SemRoCo/giskardpy/test/spoon/meshes/stl/SM_Spoon_6.stl

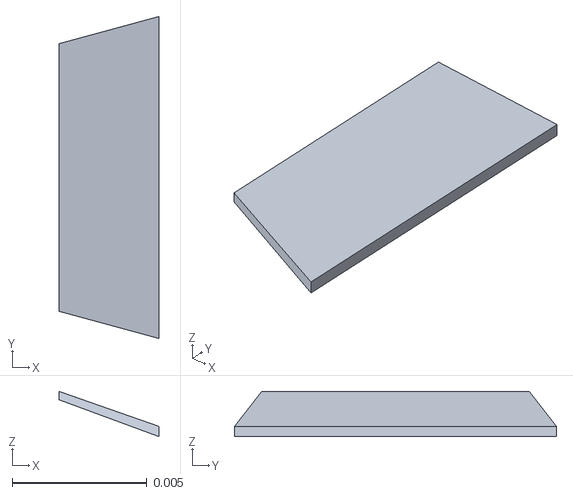
[picture p1: CAD file, 2023-09-15]
test/spoon/meshes/stl/SM_Spoon_6.stl
0.00371 x 0.012 x 0.00168
