SemRoCo/giskardpy/test/urdfs/meshes/cylinder.obj

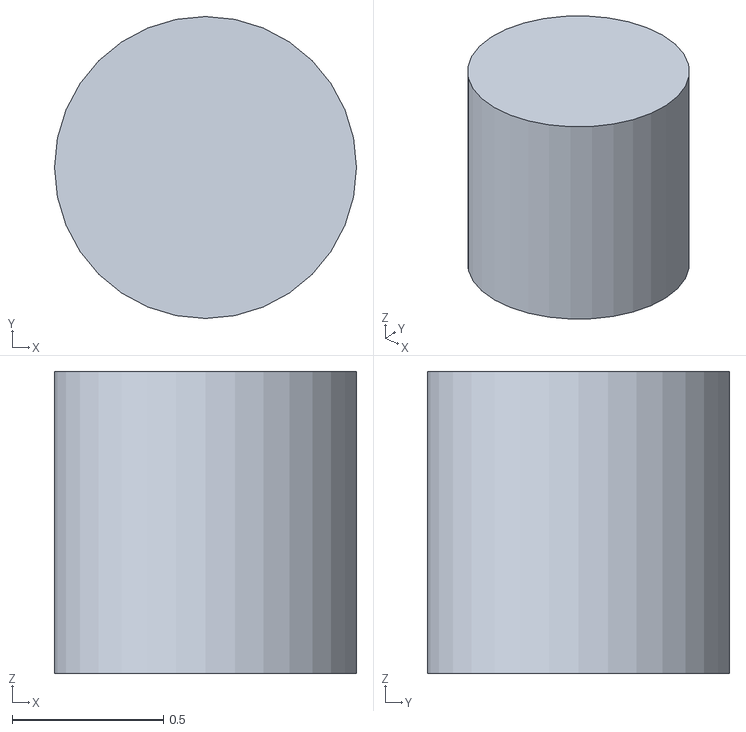
[picture p2: CAD file, 2022-06-21]
test/urdfs/meshes/cylinder.obj
1.00 x 1.00 x 1.00
