SemRoCo/giskardpy/test/spoon/meshes/stl/SM_Spoon_13.stl

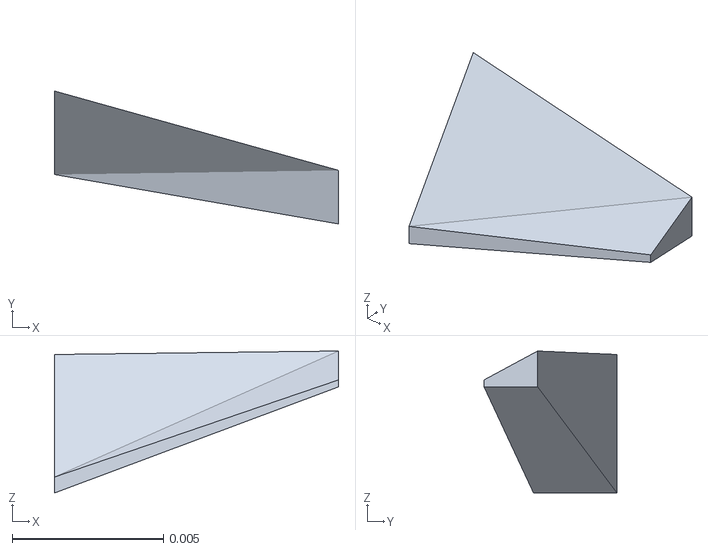
[picture p3: CAD file, 2023-09-15]
test/spoon/meshes/stl/SM_Spoon_13.stl
0.00939 x 0.0044 x 0.0047
