SemRoCo/giskardpy/test/urdfs/meshes/bowl_21.obj

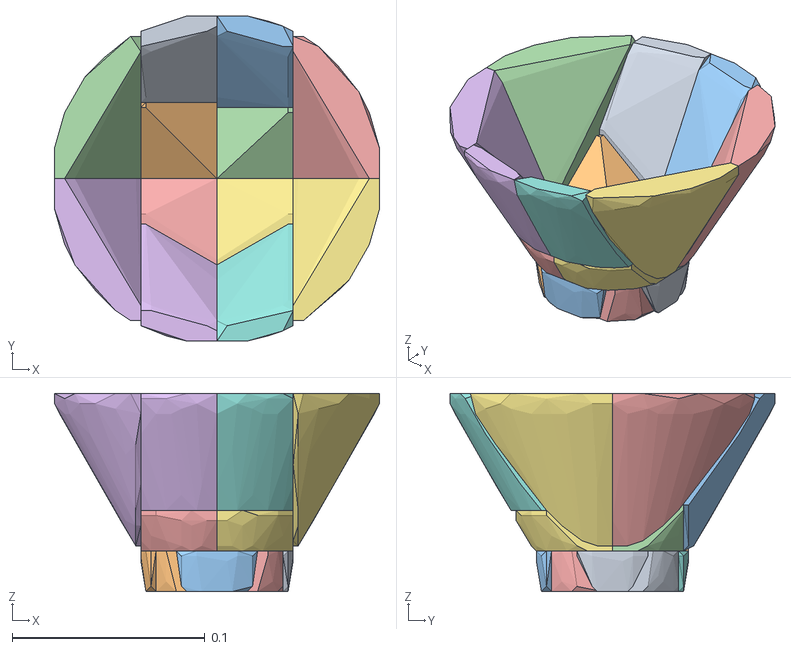
[picture p4: CAD file, 2020-11-10]
test/urdfs/meshes/bowl_21.obj
0.169 x 0.169 x 0.103
Bowl_hull_1
Bowl_hull_2
Bowl_hull_3
Bowl_hull_4
Bowl_hull_5
Bowl_hull_6
Bowl_hull_7
Bowl_hull_8
Bowl_hull_9
Bowl_hull_10
Bowl_hull_11
Bowl_hull_12
Bowl_hull_13
Bowl_hull_14
Bowl_hull_15
Bowl_hull_16
Bowl_hull_17
Bowl_hull_18
Bowl_hull_19
Bowl_hull_20
Bowl_hull_21
