SemRoCo/giskardpy/test/spoon/meshes/stl/SM_Spoon_17.stl

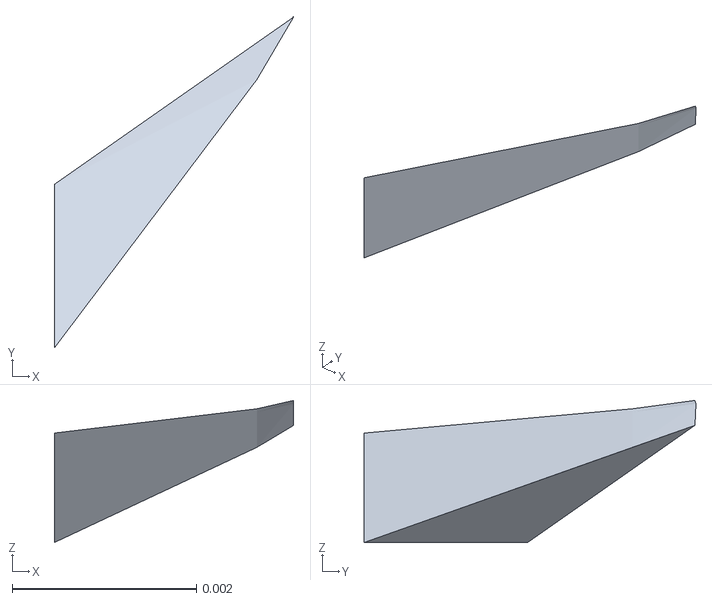
[picture p5: CAD file, 2023-09-15]
test/spoon/meshes/stl/SM_Spoon_17.stl
0.00259 x 0.0036 x 0.00154
