SemRoCo/giskardpy/test/spoon/meshes/stl/SM_Spoon_10.stl

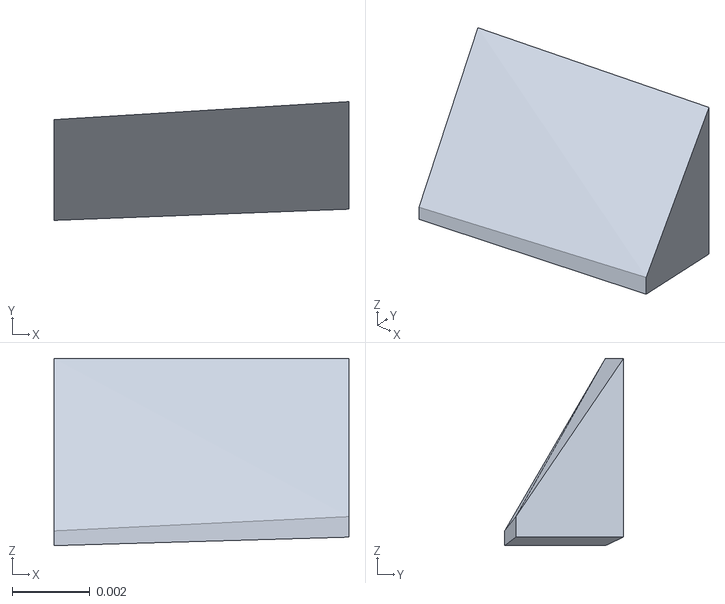
[picture p6: CAD file, 2023-09-15]
test/spoon/meshes/stl/SM_Spoon_10.stl
0.00757 x 0.00305 x 0.00481
