SemRoCo/giskardpy/test/spoon/meshes/stl/SM_Spoon_5.stl

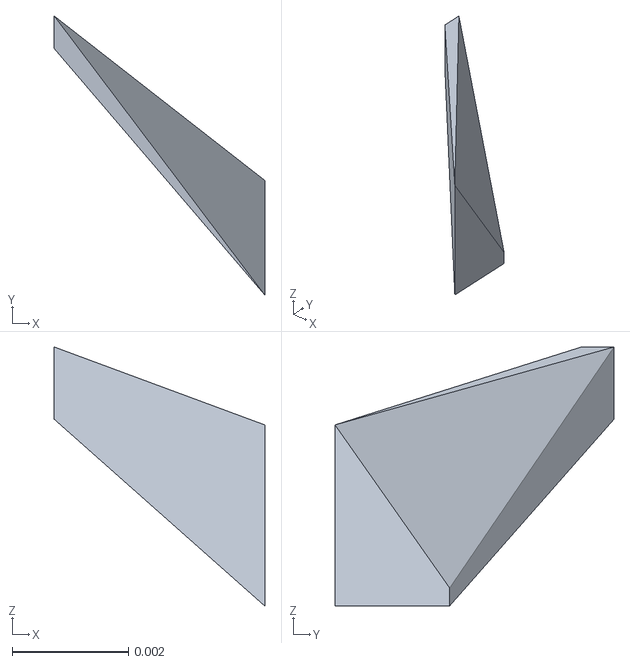
[picture p7: CAD file, 2023-09-15]
test/spoon/meshes/stl/SM_Spoon_5.stl
0.00362 x 0.0048 x 0.00445
