SemRoCo/giskardpy/test/spoon/meshes/stl/SM_Spoon_2.stl

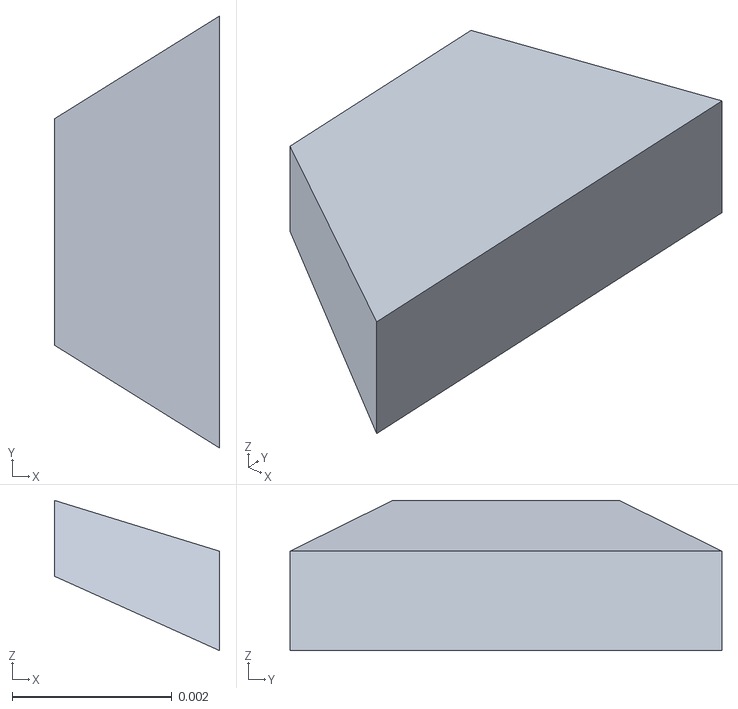
[picture p8: CAD file, 2023-09-15]
test/spoon/meshes/stl/SM_Spoon_2.stl
0.00206 x 0.0054 x 0.00188
