SemRoCo/giskardpy/test/spoon/meshes/stl/SM_Spoon_7.stl

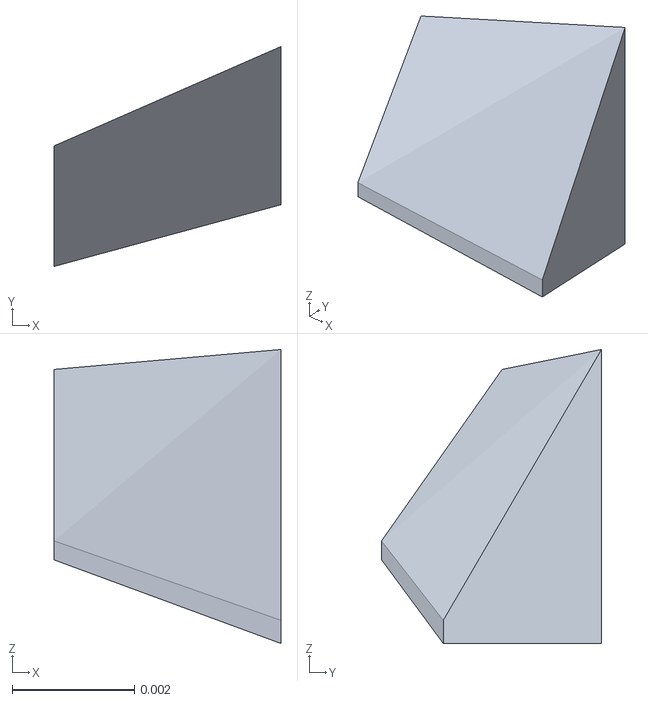
[picture p9: CAD file, 2023-09-15]
test/spoon/meshes/stl/SM_Spoon_7.stl
0.00371 x 0.0036 x 0.00481
