SemRoCo/giskardpy/test/spoon/meshes/stl/SM_Spoon_12.stl

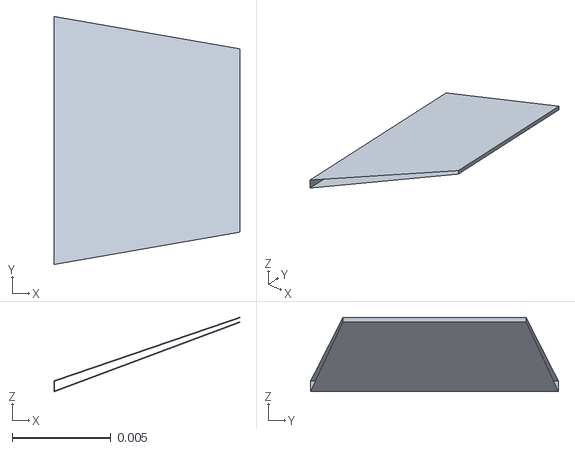
[picture p10: CAD file, 2023-09-15]
test/spoon/meshes/stl/SM_Spoon_12.stl
0.00939 x 0.0125 x 0.00374
