SemRoCo/giskardpy/test/spoon/meshes/stl/SM_Spoon_15.stl

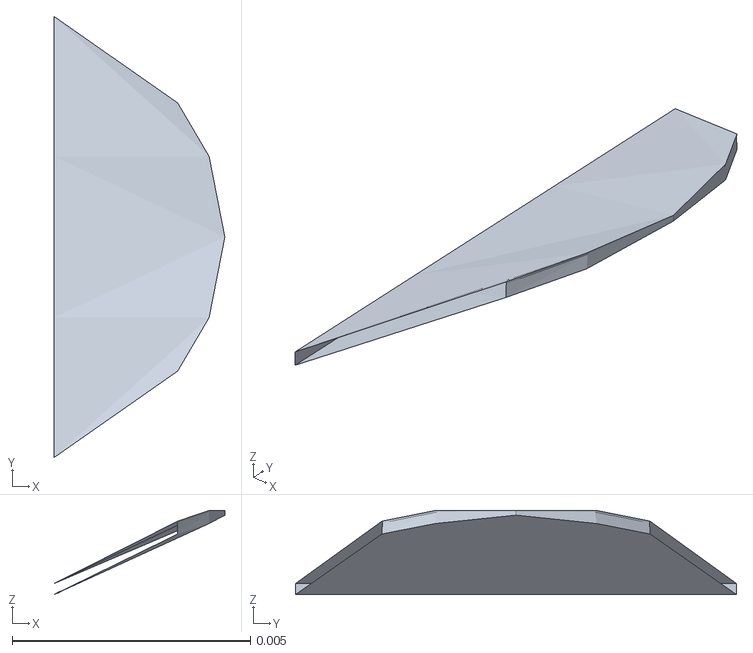
[picture p11: CAD file, 2023-09-15]
test/spoon/meshes/stl/SM_Spoon_15.stl
0.00359 x 0.00926 x 0.00177
