SemRoCo/giskardpy/test/spoon/meshes/stl/SM_Spoon_1.stl

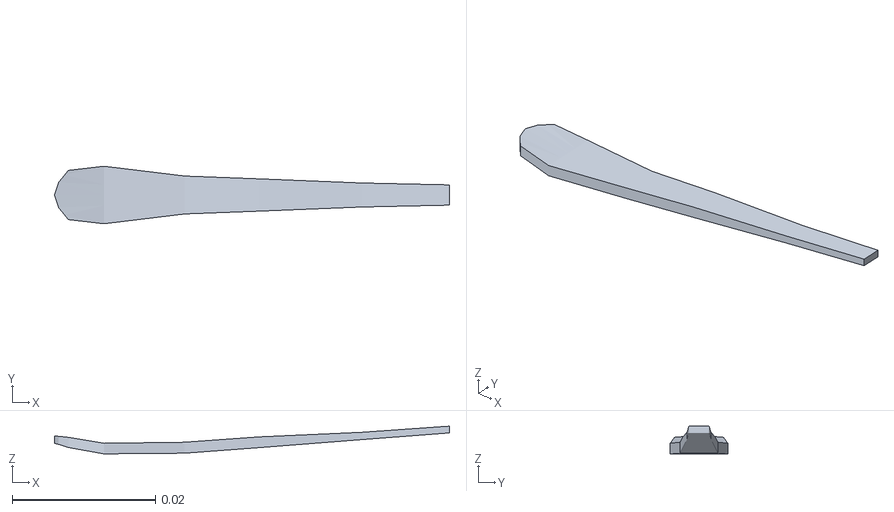
[picture p12: CAD file, 2023-09-15]
test/spoon/meshes/stl/SM_Spoon_1.stl
0.0552 x 0.00804 x 0.00388
