SemRoCo/giskardpy/test/spoon/meshes/stl/SM_Spoon_3.stl

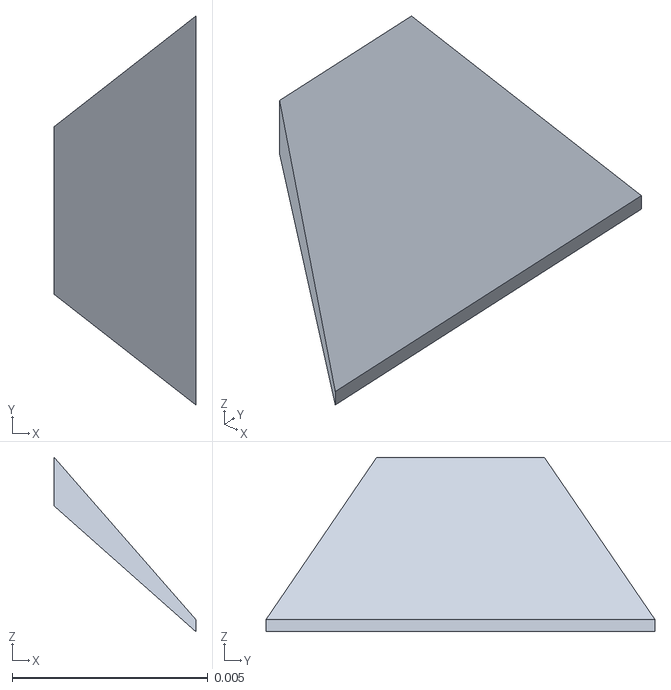
[picture p13: CAD file, 2023-09-15]
test/spoon/meshes/stl/SM_Spoon_3.stl
0.00362 x 0.00994 x 0.00445
