SemRoCo/giskardpy/test/spoon/meshes/stl/SM_Spoon_9.stl

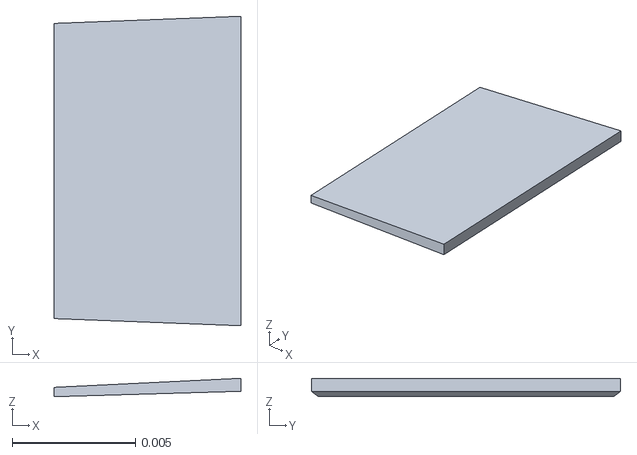
[picture p14: CAD file, 2023-09-15]
test/spoon/meshes/stl/SM_Spoon_9.stl
0.00757 x 0.0125 x 0.000746
