SemRoCo/giskardpy/(list of files, cad)

Other CAD files:
test/spoon/meshes/stl/SM_Spoon_14.stl
test/spoon/meshes/stl/SM_Spoon_16.stl
test/spoon/meshes/stl/SM_Spoon_8.stl
test/spoon/meshes/stl/SM_Spoon_11.stl
test/spoon/meshes/stl/SM_Spoon_4.stl
