SemRoCo/giskardpy/(threads)

Thread 1 (2017-10-11):

erster Durchschuß

airballking, 2017-10-11:
- [x] set up package (Simon)
- [ ] QPProblemBuilder (Adrian)
- [x] integrate qpOases (Simon ?)
- [ ] test case: point robot with 3d goal (Adrian)

@aroefer & @ichumuh is this fine for you?

ichumuh, 2017-10-11:
Yes

airballking, 2017-10-12:
I took the liberty of sketching the toy problem with specific numbers on my whiteboard. For future references, this is it:

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

Edit: I spotted a mistake in l_A: It should be (-1.3 - 1.05) instead of (1.3 - 1.05) for the second entry. Sorry about that.

Closed 2018-08-30.

Thread 5 (2017-10-30):

Runtime comparison

ichumuh, 2017-10-30:
A small benchmark using a cartesian controller on pr2. (test/test_controller.py:TestController.test_cart_controller_pr2)
Run on machine with 4ghz and 16gb ram + line_profiler.

\ | pure sympy | sympy + numpy | sympy + cython | pure symengine
--- | --- | --- | --- | ---
init (eq statements + jacobian + autowrap) | 11.5s | 21s | 53s | 0.15s
eq statements | 0.85s | 0.85s | 0.85s | <0.001s
jacobian | 9.8s | 9.8s | 9.8s | 0.05s
autowrap | - | 10.5s | 43s | -
get_next_command | 108s | 0.01s | 0.00025s | 0.049s

airballking, 2017-10-30:
@ichumuh Thanks for providing! Some quick questions:

(1) On what type of machine was that run?
(2) Could you describe (in one sentence) what 'eq statements', 'jacobian', and 'next_cmd (per hit)' mean? I feel unsure about some of them.

As a guideline, the controller should run at least 100Hz to be useful on the real robot. Faster is always better.

Also, this is running qpOases, right?

Finally, do think it makes sense to include Theano and Tensorflow into the comparison?

ichumuh, 2017-10-30:
(1) I have added the machine speccs to the opening post, the overall test is about 25-50% faster without the profiler, but hard to tell if everything is equally effected. Sorry that I forgot to mention that earlier.
(2)

- eq statements: CartesianController.make_constraints() + robot.add_chain_joints() (which creates the forward kinematic equations in sympy terms)
- jacobian: line 74 in qpbuilder
- next_cmd: controller.get_next_cmd() call, this consists of function evaluation and qp problem solving

(3) yes, and the runtime is negligible

(4) I would like to include them but it's hard for me to estimate how much time it will take.

airballking, 2017-11-01:
@ichumuh thanks for the updates and infos. What is your next step on this?

ichumuh, 2017-11-02:
I ran a few more tests -without- line profiler but on the same machine. This time I omitted pure sympy because it's too slow anyway. The next command was called 200 times.
1. For the first benchmark I used the pr2 joint state controller test as an example for a very simple controller:

\ | sympy + numpy | sympy + cython | symengine
---|---|---|---
init | 1.3 | 32 | 0.026
eq statements | 0.3 | 0.3 | 0.003
jacobian | 0.003 | 0.003 | 0.0000003
autowrap | 0.97 | 31.5 | -
get_next_command | 0.00028 | 0.00017 | 0.0055
get_next_cmd std | 0.000005 | 0.000005 | 0.0012

2. the cartesian controller from the opening post but, again, this time without the line profiler:

\ | sympy + numpy | sympy + cython | symengine
---|---|---|---
init | 7.8 | 38 | 0.125
eq statements | 0.32 | 0.32 | 0.013
jacobian | 3.2 | 3.2 | 0.046
autowrap | 4.2 | 31 | -
get_next_command | 0.0095 | 0.00013 | 0.048
get_next_cmd std | 0.0024 | 0.00004 | 0.0009

3. I have tried out a cartesian controller with the additional constraint that it tries to stay on a straight line between start and goal pose:

\ | sympy + numpy | sympy + cython | symengine
---|---|---|---
init | 13.4 | 44.2 | 0.25
eq statements | 0.4 | 0.4 | 0.03
jacobian | 5.7 | 5.7 | 0.11
autowrap | 7.2 | 37 | -
get_next_cmd mean | 0.017 | 0.00018 | 0.098
get_next_cmd std | 0.0003 | 0.000004 | 0.001

4. a controller that tries to create a certain pose of both hands relative to each other, which is what you have suggested yesterday:

\ | sympy + numpy | sympy + cython | symengine
---|---|---|---
init | 140 | 170 | 0.36
eq statements | 0.31 | 0.31 | 0.003
jacobian | 123 | 123 | 0.12
autowrap | 16 | 46 | -
get_next_command | 0.043 | 0.00012 | 0.23
get_next_cmd std | 0.0007 | 0.000004 | 0.0035

It should be noted that it takes 25s to compile the fk equations for the pr2 using cython and 0.9 using numpy. This is done every time even though it's unnecessary for the joint state controller.

As expected, symengine has no problem with differentiating huge equations. It also seems like cython's get_next_command call does not correlate with the function complexity at all.

Next I'm gonna work on adding tensorflow and theano to that list

airballking, 2017-11-02:
@ichumuh Thanks a lot for this update!

I have two questions.

When you say "it takes ...0.9s... to compile the fk equations for the pr2 using ... numpy...", do you mean that if we just write out regular numpy expressions we get (1) runtime compilation at around 1 Hz, and (2) subsequent evaluation at around 20Hz?

Why is it not possible to combine symengine with numpy or cython?

ichumuh, 2017-11-02:
Sorry, compile was not the correct word. I was referring to the autowrap step. It consists of two parts. (1) autowrap fk expressions (2) autowrap expressions that produce the matrices for the qp problem.

I need to evaluate the fk to set the default goal in all but the joint state controller. I also need it as the starting point for the line in the 3. controller. If we want to change the controller during runtime we can skip the (1) part. That would save 25s with cython for all subsequent controllers.
Additionally, we could probably compute and store this offline. Especially for cython this would save 25s in the autowrap step.

It is possible to combine these two, but symengine does not have an autowrap function.
That means we have to translate it into a sympy expression and then call sympy.autowrap. My guess is that this step would take as much time as listed in the "eq statements" row.
Do you want me to try that out?

isuruf, 2017-11-02:
symengine's lambdify has 2 backends. `lambda` and `llvm` which are comparable to sympy's `numpy` and `cython` methods.

ichumuh, 2017-11-03:
Thanks for the info! I'm gonna try that out.

airballking, 2017-11-03:
@isuruf Thanks for the tip! Which of the two backends is the default one? And, can you comment on which one is faster when generating expression vs. evaluating expressions?

Also, I am curious how you found out about our project. Are you also interested in robot control?

ichumuh, 2017-11-03:
In sympy, the method that turns expressions into numpy functions is called lambdify but the one for cython is called autowrap. I just called everything autowrap because I thought it was less confusing. If I use symengines lambdify, which I currently don't, it should introduce the "autowrap" step but speed up the evaluation time.

ichumuh, 2017-11-03:
@airballking I added symengine + lambda to the tables above. Like @isuruf said, it's comparable to numpy. lambdify takes less time but the resulting function seems to be slower.
If I try to use llvm, symengine tells me that it's not compiled with llvm support. I guess I would have to compile it from sources.

airballking, 2017-11-03:
@ichumuh thanks for the update of the tables regarding symengine + lambda.

Looking at symengine + lambda would indeed be interesting.

ichumuh, 2017-11-03:
I have compiled symengine from sources with llvm support and updated the tables. It's almost as fast as cython but the autowrap step is also super fast. The lambda version is faster as well, seems like symengine from pip is outdated.
However, with this installation my line constraint for the cart controller somehow produces infinities which causes the test to fail.
I'm gonna investigate some more.

airballking, 2017-11-03:
Aha. Sounds promising! :)

ichumuh, 2017-11-03:
I have found the problem with the line constraint, fixed it and added the number to the table.
Looks pretty good to me. The only problem left is that we have to compile symengine from sources.
I think I don't have to try out theano and tensorflow anymore right?

airballking, 2017-11-06:
@ichumuh So, you recommend going with symengine with LLVM as a backend? Looking at the worst cases from your table, that gives us 3s for compiling a new motion and 1250Hz of update frequency, correct. The former is a bit slow, while the latter is very nice.

If these numbers turn out to be correct, I think we'll have to look into caching compiled expression. @ichumuh @amaldo @aroefer What do you think?

@ichumuh how much work is it to compile symengine + LLVM from source. Do you see a way of automating the process using the ROS infrastructure?

@ichumuh I'd be interesting in comparing with Theano? How much time would it take you to do the comparison?

ichumuh, 2017-11-06:
symengine + LLVM outperforms everything else. So as long as we don't come up with anything better I think thats the way to go. I have just run the tests on my office pc (3.4 ghz 16gb ram). The worst case for the init was 4s and get_next_command 0.0012.

I think it should be relatively easy to automate this using the ros infrastructure because symengine uses cmake.

airballking, 2017-11-06:
Compiling via CMake is indeed a good fit with ROS.

Given that you told me offline that you guess it would take 1-3 days to benchmark Theano, I think we should leave that for a later time and go with symengine + LLVM for now.

isuruf, 2017-11-30:
> Also, I am curious how you found out about our project.
Just a random github search.

> Are you also interested in robot control?
Nope

If you are not doing any broadcasting or have multiple outputs, following might be faster. (It avoids a few checks in python)
```
def f(**kwargs):
        filtered_args = [kwargs[k] for k in str_params]
        out = np.empty(function.shape)
        fast_f.unsafe_real(np.array(filtered_args, dtype=np.double), out)
        return  np.nan_to_num(out)
```

Closed 2022-04-06.

Thread 15 (2018-06-28):

Missing dependency

NeumannM89, 2018-06-28:
I get "Cannot locate rosdep definition for [ros_kinetic_urdfdom_py]" during the install.

ichumuh, 2018-06-28:
try to install it manually
sudo apt-get install ros-kinetic-urdfdom-py

airballking, 2018-06-29:
I think adding ```urdfdom_py``` and the likes to the ```package.xml``` would be the better option. Then, the install instructions would automatically cause the installation.

ichumuh, 2018-06-29:
It is listed in package.xml, but rosdep didn't manage to install it.

airballking, 2018-06-29:
Oh! I just checked, the dependency was incorrectly stated. I just fixed that on that master branch. I guess we can close the issue, right?

ichumuh, 2018-06-29:
yes

Closed 2018-06-29.

Thread 17 (2018-08-17):

Change SymengineController's interface

ARoefer, 2018-08-17:
Hi,

I've recently updated an old system of mine to work with the new v0.2 version. I noticed that the new SymEngineController can only be passed a URDF path, not a Robot instance. I think this interface should be changed to accept a complete robot, since there's information that can not be encoded in URDF, like a model for base navigation.
Of course I can still inherit from the controller and override __init__ completely, but that's very unclean. To afford both use cases, the class could offer a static constructor which uses a URDF path, or the type of the given parameter could be analyzed in __init__.

ichumuh, 2018-08-20:
I agree. On the hypothesis (the name of a cool python testing framework) branch, I'm currently writing tests, refactoring and writing documentation. On that branch SymengineController only accepts a Robot class in init, to remove the urdf dependency from that class. This branch will get merge into devel_v0.2 and master when I'm finished.

ARoefer, 2018-08-20:
Alright, thank you for the update! Looking forward to the merge.

Closed 2018-08-20.

Thread 20 (2018-11-20):

Improving usability of the controller interface

ARoefer, 2018-11-20:
In my opinion, the current SymengineController interface is too complicated. It requires users to provide both the free symbols in their expressions, as well as specify exactly which joints to use. There are a couple of problems with this:

1. It requires them to manually keep track of all their free symbols and passing them to the piece of code, initializing the controller. This requires a lot of data passing, which I think is hostile to the idea of modularization.
2. Not sure whether I remember this correctly, but the used joints and the joints referenced in the soft constraints need to coincide. Meaning the user has to keep track of which joints are actually used in their expressions, leading to them having to have a very detailed knowledge of the robot they're using.
3. All the information needed to initialize the controller is already present in the soft constraints.

My suggestion is redesigning the controller initialization to include an algorithm like this one:

```python
def configure_controller(controller, robot, soft_cs, filter=set()):
    free_symbols = set()

    # Find free symbols in soft constraints
    for sc in soft_cs.values():
        for f in sc:
            if hasattr(f, 'free_symbols'):
                free_symbols = free_symbols.union(f.free_symbols)

    # Select joints referenced in soft constraints which are not supposed to be filtered out
    controller.set_controlled_joints([j for j in robot.get_joint_names() if robot.joint_to_symbol_map[j] in free_symbols and j not in filter])

    # Find additional free symbols in joint constraints
    for jc in controller.joint_constraints.values():
        for f in jc:
            if hasattr(f, 'free_symbols'):
                free_symbols = free_symbols.union(f.free_symbols)

    # Find additional free symbols in hard constraints
    for hc in controller.hard_constraints.values():
        for f in hc:
            if hasattr(f, 'free_symbols'):
                free_symbols = free_symbols.union(f.free_symbols)

    # Setting soft constraints and free symbols
    controller.update_soft_constraints(soft_cs, free_symbols)

    return free_symbols
```
I've used an algorithm like this under the old controller interface in another project of mine ([Implementation](https://github.com/ARoefer/gebsyas/blob/the_messed_up_but_working_branch/src/gebsyas/bc_controller_wrapper.py)).
@ichumuh referenced [here](https://github.com/symengine/symengine.py/issues/211) that the free_symbols call is very slow on large matrices. Personally, I've not had this problem when directly working on the expressions, but I've not profiled it either. This is definitely something to investigate.

ichumuh, 2018-11-20:
I'll make the free symbols optional, if I have some time, and check if it is faster to extract them from the constraints instead of the jacobian.

Regarding the controlled joint names:

1. They are provided by the whole body controller, so you don't really have to keep track of the joints.
2. For my robots, the whole body controller never controlled all the joints from the urdf, so I'd always had to filter.
3. I could make this optional as well, though I'd keep the current whitelist approach. A filter requires you to figure out which joints your controller does not control, which is more difficult I belief.

ARoefer, 2018-11-20:
Oh, I must've overlooked the whole body controller.
On point 3: I don't quite get how the filter requires me to know which joints are not controlled by it. The way I've always thought about the filter is as a blacklist.
Whether one prefers black- or whitelists is a matter of discussion. Personally, I think blacklists are easier to use, than whitelists, but one could also view a blacklist as a "loose cannon" approach.

ichumuh, 2018-11-21:
> I don't quite get how the filter requires me to know which joints are not controlled by it.

Isn't this kind of the definition? All the joints in the filter are removed. So if your controller doesn't control the gripper, you have to somehow figure out which joints belong to the gripper. I'd do it by computing the difference between the controlled joints and a list of all joints. This is more work than just handing over the list of joints that my controller controls. So at least for my usecases, a whitelist is more convenient.

ARoefer, 2018-11-21:
I think the difference here is really in practical usage. Instead of formulating the filter as a post processing step which removes joints, I'd view it as a pre processing which keeps joints from being added. Either way, as you point out, convenience is dependant on use case

ARoefer, 2018-12-04:
Hello, I had a free moment and decided to record the build times for some of my controllers. These are my results:

| N Symbols | N Constraints | Time Matrix Extraction | Time Constraint Extraction | Remaining Generation Time |
|-----------|---------------|------------------------|----------------------------|---------------------------|
| 103       | 20            | 0.00081s               | 0.00117s                   | 0.06416s                  |
| 116       | 28            | 0.00196s               | 0.00206s                   | 0.09415s                  |

So overall extracting the symbols from the matrix directly, seems to be faster than extracting the symbols  iteratively, though the gap seems to narrow with a rising number of constraints. I suspect it might be, that free_symbols is more complex on larger objects, while the time for the python iterations does not increase at the same rate.

Given your previous concerns, I assume you use waaaay more constraints than I do, which is why the symbol extraction becomes such an issue?

ichumuh, 2018-12-27:
Seems like .free_symbols is fast [now](https://github.com/symengine/symengine.py/issues/211#event-2043487315), which resolves this problem. With that speed I can probably remove the input parameter and always call .free_symbols.

ichumuh, 2019-01-14:
I finally had some time to look into this. The symengine controller doesn't require free symbols anymore and will use .free_symbols if none are supplied. But this is only fast if symengine is up to date.

Closed 2019-01-14.

Thread 74 (2021-04-14):

PyBullet(==3.0.8<3.1.2) Import Error

tlipps, 2021-04-14:
With the current installation script in the readme.md, testing and running giskardpy is not possible, due to of a pybullet import error. `sudo pip install pybullet` from the install script installs currently at least the version 3.1.2 on melodic. If the test code from the function `test_bowl_and_cup` is run, the following error log is produced:

```
ERROR: not found: /home/thomas/ros_ws/src/giskardpy/test/test_integration_pr2.py::TestCollisionAvoidanceGoals::test_bowl_and_cup
(no name '/home/thomas/ros_ws/src/giskardpy/test/test_integration_pr2.py::TestCollisionAvoidanceGoals::test_bowl_and_cup' in any of [<Module 'test/test_integration_pr2.py'>])

test/test_integration_pr2.py:None (test/test_integration_pr2.py)
ImportError while importing test module '/home/thomas/ros_ws/src/giskardpy/test/test_integration_pr2.py'.
Hint: make sure your test modules/packages have valid Python names.
Traceback:
/usr/lib/python2.7/dist-packages/_pytest/python.py:403: in _importtestmodule
    mod = self.fspath.pyimport(ensuresyspath=importmode)
/usr/lib/python2.7/dist-packages/py/_path/local.py:668: in pyimport
    __import__(modname)
/usr/lib/python2.7/dist-packages/_pytest/assertion/rewrite.py:213: in load_module
    py.builtin.exec_(co, mod.__dict__)
test_integration_pr2.py:22: in <module>
    from giskardpy.robot import Robot
../src/giskardpy/robot.py:12: in <module>
    from giskardpy.pybullet_world_object import PyBulletWorldObject
../src/giskardpy/pybullet_world_object.py:4: in <module>
    import giskardpy.pybullet_wrapper as pw
../src/giskardpy/pybullet_wrapper.py:6: in <module>
    import pybullet as p
E   ImportError: /home/thomas/.local/lib/python2.7/site-packages/pybullet.so: undefined symbol: PyUnicode_AsUTF8

```

The problem can be solved by using the pybullet version 3.0.8 (maybe later versions work too).

ichumuh, 2021-04-15:
It works with python3/noetic. So it seems like they broke the python 2 support. I guess that is never going to get fixed. Especially because the don't allow issues on their github anymore.
You can switch to 20.04+noetic if you want. Giskards devel works fine with it.

ichumuh, 2021-04-15:
If you do, you should look at this issue: https://github.com/code-iai/iai_maps/issues/83#issue-782218694

ichumuh, 2021-04-15:
updated readme e44d0dcf01b6fc3b57690556994d8796c91c134c

Closed 2022-04-06.

Thread 78 (2021-08-19):

MPC Solver Comparision

tlipps, 2021-08-19:
Currently profiled the cplex and gurobi solver on the mpc branch.
CPLEX LOG:
```
============================= test session starts ==============================
platform linux -- Python 3.8.10, pytest-6.2.4, py-1.10.0, pluggy-0.13.1
rootdir: /home/thomas/ros_ws/src/giskardpy
plugins: hypothesis-6.14.1
Academic license - for non-commercial use only - expires 2021-10-17
Using license file /home/thomas/gurobi.lic
collected 1 item

test/test_integration_pr2.py [/unnamed]: deleting tmp test folder
[/unnamed]: init ros
 [1mstarted roslaunch server http://thomas-MS-7C91:43495/ [0m

SUMMARY
========

PARAMETERS
 * /rosdistro: noetic
 * /rosversion: 1.15.11

NODES

 [1mROS_MASTER_URI=http://localhost:11311 [0m
 [1mprocess[joint_trajectory_splitter-1]: started with pid [64102] [0m
[INFO] [1629978455.212171]: [/tests]: --> added ground_plane to world
[INFO] [1629978455.218782]: [/tests]: --> added pybullet_hack to world
[INFO] [1629978455.633305]: [/tests]: --> added pr2 to world
[INFO] [1629978455.808199]: [/tests]: loaded self collision matrix /home/thomas/ros_ws/src/giskardpy/tmp_data/collision_matrix//pr2/ecde0c3a330b5e4a094b7ca46100a7e5
[INFO] [1629978455.812867]: [/tests]: waiting for action server '/whole_body_controller/follow_joint_trajectory' to appear
[INFO] [1629978455.813671]: [/tests]: successfully connected to action server
[INFO] [1629978455.821130]: [/tests]: Writing /home/thomas/ros_ws/src/giskardpy/tmp_data/tree.dot/svg/png
[INFO] [1629978458.040919]: [/tests]: resetting giskard
[INFO] [1629978458.046792]: [/tests]: <-- removed object ground_plane from world
[INFO] [1629978458.048391]: [/tests]: <-- removed object pybullet_hack from world
[INFO] [1629978458.233745]: [/tests]: loaded self collision matrix /home/thomas/ros_ws/src/giskardpy/tmp_data/collision_matrix//pr2/ecde0c3a330b5e4a094b7ca46100a7e5
[INFO] [1629978458.240826]: [/tests]: --> added ground_plane to world
[INFO] [1629978458.247606]: [/tests]: --> added pybullet_hack to world
[INFO] [1629978459.266986]: [/tests]: Received new goal.
[INFO] [1629978459.276686]: [/tests]: Parsing goal message.
[INFO] [1629978459.277985]: [/tests]: Adding constraint of type: 'JointPositionList'
[INFO] [1629978459.284542]: [/tests]: done parsing goal message
[INFO] [1629978459.882159]: [/tests]: Using QP Solver 'cplex'
[INFO] [1629978459.883301]: [/tests]: Constructing new controller with 494 constraints and 557 free variables...
[INFO] [1629978459.947023]: [/tests]: computed Jacobian in 0.00059s
[INFO] [1629978460.127668]: [/tests]: Compiled symbolic controller in 0.02695s
[INFO] [1629978461.598317]: [/tests]: found loop, stopped planning.
[INFO] [1629978461.600065]: [/tests]: found goal trajectory with length 1.05s in 2.3144121170043945s
[INFO] [1629978462.134066]: [/tests]: Planning succeeded.
[INFO] [1629978462.135605]: [/tests]: Sending trajectory to robot.
[INFO] [1629978464.737757]: [/tests]: Robot successfully executed the trajectory.
[INFO] [1629978464.740212]: [/tests]: Successfully executed goal.
[INFO] [1629978465.465906]: [/tests]: --> added kitchen to world
[INFO] [1629978466.592754]: [/tests]: Received new goal.
[INFO] [1629978466.622580]: [/tests]: adding 24 external collision avoidance constraints
[INFO] [1629978466.734150]: [/tests]: adding 67 self collision avoidance constraints
[INFO] [1629978466.735111]: [/tests]: Parsing goal message.
[INFO] [1629978466.735846]: [/tests]: Adding constraint of type: 'CartesianPosition'
[INFO] [1629978466.739642]: [/tests]: Adding constraint of type: 'CartesianOrientation'
[INFO] [1629978466.754561]: [/tests]: done parsing goal message
[INFO] [1629978466.798315]: [/tests]: Using QP Solver 'cplex'
[INFO] [1629978466.800689]: [/tests]: Constructing new controller with 588 constraints and 651 free variables...
[INFO] [1629978466.916219]: [/tests]: computed Jacobian in 0.03585s
[INFO] [1629978467.234375]: [/tests]: Compiled symbolic controller in 0.05548s
[INFO] [1629978474.393086]: [/tests]: found goal trajectory with length 3.4000000000000004s in 7.637590169906616s
[INFO] [1629978475.078298]: [/tests]: Planning succeeded.
[INFO] [1629978475.080597]: [/tests]: Sending trajectory to robot.
[INFO] [1629978479.983126]: [/tests]: Robot successfully executed the trajectory.
[INFO] [1629978479.986314]: [/tests]: Successfully executed goal.
[INFO] [1629978480.613513]: [/tests]: Received new goal.
[INFO] [1629978480.644307]: [/tests]: adding 24 external collision avoidance constraints
[INFO] [1629978480.731220]: [/tests]: adding 67 self collision avoidance constraints
[INFO] [1629978480.732925]: [/tests]: Parsing goal message.
[INFO] [1629978480.733775]: [/tests]: Adding constraint of type: 'CartesianPosition'
[INFO] [1629978480.737611]: [/tests]: Adding constraint of type: 'CartesianOrientation'
[INFO] [1629978480.752850]: [/tests]: done parsing goal message
[INFO] [1629978480.786566]: [/tests]: Using QP Solver 'cplex'
[INFO] [1629978480.796820]: [/tests]: Constructing new controller with 588 constraints and 651 free variables...
[INFO] [1629978480.919541]: [/tests]: computed Jacobian in 0.03618s
[INFO] [1629978481.214229]: [/tests]: Compiled symbolic controller in 0.04926s
[INFO] [1629978484.757354]: [/tests]: found goal trajectory with length 1.9500000000000002s in 4.0035388469696045s
[INFO] [1629978485.416147]: [/tests]: Planning succeeded.
[INFO] [1629978485.418221]: [/tests]: Sending trajectory to robot.
[INFO] [1629978488.920438]: [/tests]: Robot successfully executed the trajectory.
[INFO] [1629978488.923079]: [/tests]: Successfully executed goal.
[INFO] [1629978489.556112]: [/tests]: --> added cup to world
[INFO] [1629978489.567816]: [/tests]: --> added bowl to world
[INFO] [1629978490.078862]: [/tests]: Received new goal.
[INFO] [1629978490.116721]: [/tests]: adding 24 external collision avoidance constraints
[INFO] [1629978490.213189]: [/tests]: adding 67 self collision avoidance constraints
[INFO] [1629978490.214684]: [/tests]: Parsing goal message.
[INFO] [1629978490.215931]: [/tests]: Adding constraint of type: 'JointPositionList'
[INFO] [1629978490.223738]: [/tests]: done parsing goal message
[INFO] [1629978490.262139]: [/tests]: Using QP Solver 'cplex'
[INFO] [1629978490.268890]: [/tests]: Constructing new controller with 585 constraints and 648 free variables...
[INFO] [1629978490.370488]: [/tests]: computed Jacobian in 0.03480s
[INFO] [1629978490.638755]: [/tests]: Compiled symbolic controller in 0.05247s
[INFO] [1629978494.904967]: [/tests]: found goal trajectory with length 2.1s in 4.6799726486206055s
[INFO] [1629978495.450770]: [/tests]: Planning succeeded.
[INFO] [1629978495.453092]: [/tests]: Sending trajectory to robot.
[INFO] [1629978499.055453]: [/tests]: Robot successfully executed the trajectory.
[INFO] [1629978499.058174]: [/tests]: Successfully executed goal.
[INFO] [1629978499.698172]: [/tests]: Received new goal.
[INFO] [1629978499.732145]: [/tests]: adding 24 external collision avoidance constraints
[INFO] [1629978499.818161]: [/tests]: adding 67 self collision avoidance constraints
[INFO] [1629978499.819111]: [/tests]: Parsing goal message.
[INFO] [1629978499.819873]: [/tests]: Adding constraint of type: 'CartesianPosition'
[INFO] [1629978499.823632]: [/tests]: Adding constraint of type: 'CartesianOrientation'
[INFO] [1629978499.838622]: [/tests]: Adding constraint of type: 'AvoidJointLimits'
[INFO] [1629978499.845501]: [/tests]: Adding constraint of type: 'CartesianPosition'
[INFO] [1629978499.849008]: [/tests]: Adding constraint of type: 'CartesianOrientation'
[INFO] [1629978499.868665]: [/tests]: done parsing goal message
[INFO] [1629978499.901442]: [/tests]: Using QP Solver 'cplex'
[INFO] [1629978499.908122]: [/tests]: Constructing new controller with 623 constraints and 686 free variables...
[INFO] [1629978500.030921]: [/tests]: computed Jacobian in 0.03831s
[INFO] [1629978500.367403]: [/tests]: Compiled symbolic controller in 0.05560s
[INFO] [1629978530.928771]: [/tests]: found goal trajectory with length 14.4s in 31.05909490585327s
[INFO] [1629978531.970774]: [/tests]: Planning succeeded.
[INFO] [1629978531.976300]: [/tests]: Sending trajectory to robot.
[INFO] [1629978547.879877]: [/tests]: Robot successfully executed the trajectory.
[INFO] [1629978547.886019]: [/tests]: Successfully executed goal.
[INFO] [1629978548.636726]: [/tests]: Received new goal.
[INFO] [1629978548.667628]: [/tests]: adding 24 external collision avoidance constraints
[INFO] [1629978548.753918]: [/tests]: adding 67 self collision avoidance constraints
[INFO] [1629978548.754908]: [/tests]: Parsing goal message.
[INFO] [1629978548.755689]: [/tests]: Adding constraint of type: 'CartesianPosition'
[INFO] [1629978548.759452]: [/tests]: Adding constraint of type: 'CartesianOrientation'
[INFO] [1629978548.774266]: [/tests]: Adding constraint of type: 'CartesianPosition'
[INFO] [1629978548.777704]: [/tests]: Adding constraint of type: 'CartesianOrientation'
[INFO] [1629978548.793640]: [/tests]: Adding constraint of type: 'AvoidJointLimits'
[INFO] [1629978548.799712]: [/tests]: done parsing goal message
[INFO] [1629978548.836701]: [/tests]: Using QP Solver 'cplex'
[INFO] [1629978548.844775]: [/tests]: Constructing new controller with 623 constraints and 686 free variables...
[INFO] [1629978548.966535]: [/tests]: computed Jacobian in 0.04078s
[INFO] [1629978549.308720]: [/tests]: Compiled symbolic controller in 0.05719s
[INFO] [1629978552.372835]: [/tests]: found goal trajectory with length 1.4500000000000002s in 3.5722618103027344s
[INFO] [1629978553.183286]: [/tests]: Planning succeeded.
[INFO] [1629978553.185855]: [/tests]: Sending trajectory to robot.
[INFO] [1629978556.188158]: [/tests]: Robot successfully executed the trajectory.
[INFO] [1629978556.190729]: [/tests]: Successfully executed goal.
[INFO] [1629978556.477449]: [/tests]: loaded self collision matrix /home/thomas/ros_ws/src/giskardpy/tmp_data/collision_matrix//pr2/ec215eac38447a645a43a0e386e573ba
[INFO] [1629978556.479047]: [/tests]: <-- removed object bowl from world
[INFO] [1629978556.480302]: [/tests]: --> attached object bowl on link l_gripper_tool_frame
[INFO] [1629978557.280504]: [/tests]: loaded self collision matrix /home/thomas/ros_ws/src/giskardpy/tmp_data/collision_matrix//pr2/18ea9e3ed275976de97fd7d83b11e4c0
[INFO] [1629978557.282115]: [/tests]: <-- removed object cup from world
[INFO] [1629978557.283467]: [/tests]: --> attached object cup on link r_gripper_tool_frame
[INFO] [1629978558.538249]: [/tests]: Received new goal.
[INFO] [1629978558.569864]: [/tests]: adding 24 external collision avoidance constraints
[INFO] [1629978558.682880]: [/tests]: adding 71 self collision avoidance constraints
[INFO] [1629978558.684307]: [/tests]: Parsing goal message.
[INFO] [1629978558.685121]: [/tests]: Adding constraint of type: 'JointPositionList'
[INFO] [1629978558.688991]: [/tests]: done parsing goal message
[INFO] [1629978558.757455]: [/tests]: Using QP Solver 'cplex'
[INFO] [1629978558.764526]: [/tests]: Constructing new controller with 589 constraints and 652 free variables...
[INFO] [1629978558.981904]: [/tests]: computed Jacobian in 0.04590s
[INFO] [1629978559.267898]: [/tests]: Compiled symbolic controller in 0.05237s
[INFO] [1629978566.282355]: [/tests]: found goal trajectory with length 3.5500000000000003s in 7.5924036502838135s
[INFO] [1629978566.892851]: [/tests]: Planning succeeded.
[INFO] [1629978566.895300]: [/tests]: Sending trajectory to robot.
[INFO] [1629978571.998926]: [/tests]: Robot successfully executed the trajectory.
[INFO] [1629978572.002298]: [/tests]: Successfully executed goal.
[INFO] [1629978573.151287]: [/tests]: Received new goal.
[INFO] [1629978573.183784]: [/tests]: adding 24 external collision avoidance constraints
[INFO] [1629978573.279612]: [/tests]: adding 71 self collision avoidance constraints
[INFO] [1629978573.280616]: [/tests]: Parsing goal message.
[INFO] [1629978573.281432]: [/tests]: Adding constraint of type: 'CartesianPosition'
[INFO] [1629978573.285419]: [/tests]: Adding constraint of type: 'CartesianOrientation'
[INFO] [1629978573.301624]: [/tests]: Adding constraint of type: 'CartesianPosition'
[INFO] [1629978573.305447]: [/tests]: Adding constraint of type: 'CartesianOrientation'
[INFO] [1629978573.320506]: [/tests]: Adding constraint of type: 'AvoidJointLimits'
[INFO] [1629978573.326976]: [/tests]: done parsing goal message
[INFO] [1629978573.360093]: [/tests]: Using QP Solver 'cplex'
[INFO] [1629978573.367996]: [/tests]: Constructing new controller with 627 constraints and 690 free variables...
[INFO] [1629978573.488476]: [/tests]: computed Jacobian in 0.04244s
[INFO] [1629978573.837797]: [/tests]: Compiled symbolic controller in 0.06201s
[INFO] [1629978588.394686]: [/tests]: found goal trajectory with length 6.5s in 15.066822528839111s
[INFO] [1629978589.352077]: [/tests]: Planning succeeded.
[INFO] [1629978589.355423]: [/tests]: Sending trajectory to robot.
[INFO] [1629978597.358939]: [/tests]: Robot successfully executed the trajectory.
[INFO] [1629978597.362986]: [/tests]: Successfully executed goal.
[INFO] [1629978597.717187]: [/tests]: loaded self collision matrix /home/thomas/ros_ws/src/giskardpy/tmp_data/collision_matrix//pr2/786f1bb9c72261bfb00d7040c1094436
[INFO] [1629978597.718254]: [/tests]: <-- detached bowl from link l_gripper_tool_frame
[INFO] [1629978597.723283]: [/tests]: --> added bowl to world
[INFO] [1629978597.999594]: [/tests]: loaded self collision matrix /home/thomas/ros_ws/src/giskardpy/tmp_data/collision_matrix//pr2/ecde0c3a330b5e4a094b7ca46100a7e5
[INFO] [1629978598.001135]: [/tests]: <-- detached cup from link r_gripper_tool_frame
[INFO] [1629978598.009357]: [/tests]: --> added cup to world
[INFO] [1629978598.677806]: [/tests]: Received new goal.
[INFO] [1629978598.710695]: [/tests]: adding 24 external collision avoidance constraints
[INFO] [1629978598.812747]: [/tests]: adding 67 self collision avoidance constraints
[INFO] [1629978598.813881]: [/tests]: Parsing goal message.
[INFO] [1629978598.814684]: [/tests]: Adding constraint of type: 'JointPositionList'
[INFO] [1629978598.818637]: [/tests]: done parsing goal message
[INFO] [1629978599.463532]: [/tests]: Using QP Solver 'cplex'
[INFO] [1629978599.470930]: [/tests]: Constructing new controller with 585 constraints and 648 free variables...
[INFO] [1629978599.579759]: [/tests]: computed Jacobian in 0.03437s
[INFO] [1629978599.873756]: [/tests]: Compiled symbolic controller in 0.05685s
[INFO] [1629978607.375621]: [/tests]: found goal trajectory with length 3.85s in 8.556075096130371s
[INFO] [1629978607.951463]: [/tests]: Planning succeeded.
[INFO] [1629978607.954300]: [/tests]: Sending trajectory to robot.
[INFO] [1629978613.356988]: [/tests]: Robot successfully executed the trajectory.
[INFO] [1629978613.360430]: [/tests]: Successfully executed goal.
.[INFO] [1629978614.489301]: [/tests]: total time spend giskarding: 98.64897012710571
[INFO] [1629978614.491064]: [/tests]: total time spend moving: 51.333242416381836
[INFO] [1629978614.493039]: [/tests]: stopping tree
 [1m[joint_trajectory_splitter-1] process has finished cleanly
log file: /home/thomas/.ros/log/caa7b2da-0661-11ec-874d-2b0ad8ddaf6c/joint_trajectory_splitter-1*.log [0m
[INFO] [1629978615.197911]: [/tests]: shutdown ros
[INFO] [1629978615.800826]: [/tests]: deleting tmp test folder

=============================== warnings summary ===============================
../../../../../usr/lib/python3/dist-packages/Cryptodome/Util/_raw_api.py:41
  /usr/lib/python3/dist-packages/Cryptodome/Util/_raw_api.py:41: DeprecationWarning: the imp module is deprecated in favour of importlib; see the module's documentation for alternative uses
    import imp

-- Docs: https://docs.pytest.org/en/stable/warnings.html
=================== 1 passed, 1 warning in 167.14s (0:02:47) ===================
Wrote profile results to py.test.lprof
Timer unit: 1e-06 s

Total time: 7.96541 s
File: /home/thomas/ros_ws/src/giskardpy/src/giskardpy/model/pybullet_world.py
Function: check_collisions at line 39

Line #      Hits         Time  Per Hit   % Time  Line Contents
==============================================================
    39                                               @profile
    40                                               def check_collisions(self, cut_off_distances, collision_list_size=15):
    41                                                   """
    42                                                   :param cut_off_distances: (robot_link, body_b, link_b) -> cut off distance. Contacts between objects not in this
    43                                                                               dict or further away than the cut off distance will be ignored.
    44                                                   :type cut_off_distances: dict
    45                                                   :param self_collision_d: distances grater than this value will be ignored
    46                                                   :type self_collision_d: float
    47                                                   :type enable_self_collision: bool
    48                                                   :return: (robot_link, body_b, link_b) -> Collision
    49                                                   :rtype: Collisions
    50                                                   """
    51       765      50728.0     66.3      0.6          collisions = Collisions(self.robot, collision_list_size)
    52       765       3995.0      5.2      0.1          robot_name = self.robot.get_name()
    53    278190     318808.0      1.1      4.0          for (robot_link, body_b, link_b), distance in cut_off_distances.items():
    54    277425     202433.0      0.7      2.5              if robot_name == body_b:
    55    212439     276747.0      1.3      3.5                  object_id = self.robot.get_pybullet_id()
    56    212439     243339.0      1.1      3.1                  link_b_id = self.robot.get_pybullet_link_id(link_b)
    57                                                       else:
    58     64986     148578.0      2.3      1.9                  object_id = self.__get_pybullet_object_id(body_b)
    59     64986     144915.0      2.2      1.8                  if link_b != CollisionEntry.ALL:
    60                                                               link_b_id = self.get_object(body_b).get_pybullet_link_id(link_b)
    61                                   
    62    277425     342499.0      1.2      4.3              robot_link_id = self.robot.get_pybullet_link_id(robot_link)
    63    277425     248292.0      0.9      3.1              if body_b == robot_name or link_b != CollisionEntry.ALL:
    64    424878     960986.0      2.3     12.1                  contacts = [ContactInfo(*x) for x in p.getClosestPoints(self.robot.get_pybullet_id(), object_id,
    65    212439     128916.0      0.6      1.6                                                                          distance * 1.1,
    66    212439     105990.0      0.5      1.3                                                                          robot_link_id, link_b_id)]
    67                                                       else:
    68    129972    1511963.0     11.6     19.0                  contacts = [ContactInfo(*x) for x in p.getClosestPoints(self.robot.get_pybullet_id(), object_id,
    69     64986      36664.0      0.6      0.5                                                                          distance * 1.1,
    70     64986      32462.0      0.5      0.4                                                                          robot_link_id)]
    71    277425     216134.0      0.8      2.7              if len(contacts) > 0:
    72      3642       2066.0      0.6      0.0                  try:
    73      3642       3816.0      1.0      0.0                      body_b_object = self.get_object(body_b)
    74       196        159.0      0.8      0.0                  except KeyError:
    75       196        212.0      1.1      0.0                      body_b_object = self.robot
    76                                                           pass
    77      9558       7542.0      0.8      0.1                  for contact in contacts:  # type: ContactInfo
    78      5916       4345.0      0.7      0.1                      if link_b == CollisionEntry.ALL:
    79      5720       7175.0      1.3      0.1                          link_b_tmp = body_b_object.pybullet_link_id_to_name(contact.link_index_b)
    80                                                               else:
    81       196        116.0      0.6      0.0                          link_b_tmp = link_b
    82      5916     696816.0    117.8      8.7                      if self.__should_flip_collision(contact.position_on_a, robot_link):
    83       116        110.0      0.9      0.0                          flipped_normal = [-contact.contact_normal_on_b[0],
    84        58         46.0      0.8      0.0                                            -contact.contact_normal_on_b[1],
    85        58         38.0      0.7      0.0                                            -contact.contact_normal_on_b[2]]
    86       116        290.0      2.5      0.0                          collision = Collision(robot_link, body_b, link_b_tmp,
    87        58         45.0      0.8      0.0                                                contact.position_on_b, contact.position_on_a,
    88        58         45.0      0.8      0.0                                                flipped_normal, contact.contact_distance)
    89        58     100421.0   1731.4      1.3                          collisions.add(collision)
    90                                                               else:
    91     11716      27662.0      2.4      0.3                          collision = Collision(robot_link, body_b, link_b_tmp,
    92      5858       4617.0      0.8      0.1                                                contact.position_on_a, contact.position_on_b,
    93      5858       3874.0      0.7      0.0                                                contact.contact_normal_on_b, contact.contact_distance)
    94      5858    2132151.0    364.0     26.8                          collisions.add(collision)
    95       765        417.0      0.5      0.0          return collisions

Total time: 0.274101 s
File: /home/thomas/ros_ws/src/giskardpy/src/giskardpy/model/pybullet_world.py
Function: add_object at line 155

Line #      Hits         Time  Per Hit   % Time  Line Contents
==============================================================
   155                                               @profile
   156                                               def add_object(self, object_):
   157                                                   """
   158                                                   :type object_: giskardpy.world_object.WorldObject
   159                                                   :return:
   160                                                   """
   161                                                   # TODO create from world object to avoid basepose and joint state getting lost?
   162         9          6.0      0.7      0.0          try:
   163         9     263401.0  29266.8     96.1              pwo = PyBulletWorldObject.from_urdf_object(object_)
   164         9        712.0     79.1      0.3              pwo.base_pose = object_.base_pose
   165         9        477.0     53.0      0.2              pwo.joint_state = object_.joint_state
   166                                                   except Exception as e:
   167                                                       if isinstance(e, error):
   168                                                           raise CorruptShapeException(e)
   169                                                       raise e
   170         9       9505.0   1056.1      3.5          return super(PyBulletWorld, self).add_object(pwo)

Total time: 0.512115 s
File: /home/thomas/ros_ws/src/giskardpy/src/giskardpy/model/pybullet_world_object.py
Function: __init__ at line 20

Line #      Hits         Time  Per Hit   % Time  Line Contents
==============================================================
    20                                               @profile
    21                                               def __init__(self, urdf, base_pose=None, controlled_joints=None, path_to_data_folder=u'',
    22                                                            calc_self_collision_matrix=False, *args, **kwargs):
    23                                                   """
    24                                                   :type name: str
    25                                                   :param urdf: Path to URDF file, or content of already loaded URDF file.
    26                                                   :type urdf: str
    27                                                   :type base_pose: Transform
    28                                                   :type calc_self_collision_matrix: bool
    29                                                   :param path_to_data_folder: where the self collision matrix is stored
    30                                                   :type path_to_data_folder: str
    31                                                   """
    32        10          8.0      0.8      0.0          self._pybullet_id = None
    33        10          4.0      0.4      0.0          self.mimic_cb = {}
    34        10        917.0     91.7      0.2          self.lock = Lock()
    35        40     511144.0  12778.6     99.8          super(PyBulletWorldObject, self).__init__(urdf,
    36        10          6.0      0.6      0.0                                                    base_pose=base_pose,
    37        10          4.0      0.4      0.0                                                    controlled_joints=controlled_joints,
    38        10          3.0      0.3      0.0                                                    path_to_data_folder=path_to_data_folder,
    39        10          4.0      0.4      0.0                                                    calc_self_collision_matrix=calc_self_collision_matrix,
    40        20          9.0      0.5      0.0                                                    *args, **kwargs)
    41        10         10.0      1.0      0.0          self.self_collision_matrix = set()
    42        10          6.0      0.6      0.0          self.render = False

Total time: 0.989845 s
File: /home/thomas/ros_ws/src/giskardpy/src/giskardpy/model/pybullet_world_object.py
Function: joint_state at line 45

Line #      Hits         Time  Per Hit   % Time  Line Contents
==============================================================
    45                                               @WorldObject.joint_state.setter
    46                                               @profile
    47                                               def joint_state(self, value):
    48                                                   """
    49                                                   :param joint_state:
    50                                                   :type joint_state: JointStates
    51                                                   :return:
    52                                                   """
    53       903       1590.0      1.8      0.2          with self.lock:
    54       903       4661.0      5.2      0.5              WorldObject.joint_state.fset(self, value)
    55     42685      15634.0      0.4      1.6              for joint_name, singe_joint_state in value.items():
    56                                                           # FIXME hack because pybullet doesn't support mimic joints
    57     41782     123999.0      3.0     12.5                  if not self.is_joint_mimic(joint_name):
    58     83564     813178.0      9.7     82.2                      pw.resetJointState(self._pybullet_id, self.joint_name_to_info[joint_name].joint_index,
    59     41782      13814.0      0.3      1.4                                        singe_joint_state.position)
    60     41782      16969.0      0.4      1.7                  if joint_name in self.mimic_cb:
    61                                                               mimic_joint, cb = self.mimic_cb[joint_name]
    62                                                               mimiced_position = cb(singe_joint_state.position)
    63                                                               pw.resetJointState(self._pybullet_id, self.joint_name_to_info[mimic_joint].joint_index,
    64                                                                                 mimiced_position)
    65                                                           else:
    66                                                               pass

Total time: 1.27827 s
File: /home/thomas/ros_ws/src/giskardpy/src/giskardpy/model/pybullet_world_object.py
Function: reinitialize at line 121

Line #      Hits         Time  Per Hit   % Time  Line Contents
==============================================================
   121                                               @profile
   122                                               def reinitialize(self):
   123        16         30.0      1.9      0.0          with self.lock:
   124        16     975181.0  60948.8     76.3              super(PyBulletWorldObject, self).reinitialize()
   125        16
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
