SemRoCo/giskardpy/test/urdfs/boxy.urdf

<?xml version="1.0" ?>
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
<robot name="boxy_description" xmlns:controller="http://playerstage.sourceforge.net/gazebo/xmlschema/#controller" xmlns:interface="http://playerstage.sourceforge.net/gazebo/xmlschema/#interface" xmlns:sensor="http://playerstage.sourceforge.net/gazebo/xmlschema/#sensor" xmlns:xacro="http://www.ros.org/wiki/xacro">
  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
  <link name="base_link">
    <inertial>
      <origin rpy="0 0 0" xyz="-0.257082749974343 -0.227847593519202 0.0535404411050965"/>
      <mass value="70.0210745907357"/>
      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
    </inertial>
    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
  </link>
  <link name="laser_reference_front"/>
  <joint name="laser_reference_front_joint" type="fixed">
    <origin rpy="-4.1881E-15 -4.2124E-15 0.7854" xyz="0.19107 0.0506 0.1575"/>
    <parent link="base_link"/>
    <child link="laser_reference_front"/>
    <axis xyz="-0.99849 0 -0.054862"/>
  </joint>
  <link name="laser_reference_back"/>
  <joint name="laser_reference_back_joint" type="fixed">
    <origin rpy="4.9333E-15 4.5082E-15 -2.3562" xyz="-0.69357 -0.506 0.1575"/>
    <parent link="base_link"/>
    <child link="laser_reference_back"/>
    <axis xyz="-1 0 0"/>
  </joint>
  <link name="base_footprint">
    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
  </link>
  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
  <joint name="base_footprint_joint" type="fixed">
    <origin rpy="0 0 0" xyz="0.36 0.25 0.16"/>
    <parent link="base_footprint"/>
    <child link="base_link"/>
  </joint>
  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
  <joint name="neck_adapter_ur3_in_joint" type="fixed">
    <origin rpy="0 0 0" xyz="0.175 -0.227 1.48"/>
    <parent link="base_link"/>
    <child link="neck_adapter_ur3_frame_in"/>
  </joint>
  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
  <link name="neck_adapter_ur3_frame_in">
    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
  </link>
  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
  <joint name="neck_adapter_ur3_trans_frame_out" type="fixed">
    <origin rpy="0 0 0" xyz="0 0 0.003"/>
    <parent link="neck_adapter_ur3_frame_in"/>
    <child link="neck_adapter_ur3_frame_out"/>
  </joint>
  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
  <link name="neck_adapter_ur3_frame_out"/>
  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
  <joint name="neck_mounting_joint" type="fixed">
    <parent link="neck_adapter_ur3_frame_out"/>
    <child link="neck_base_link"/>
    <origin rpy="0.0 0.0 -1.57079632679" xyz="0.0 0.0 0.0"/>
  </joint>
  <link name="neck_base_link">
    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
    <inertial>
      <mass value="2.0"/>
      <origin rpy="0 0 0" xyz="0.0 0.0 0.0"/>
      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
    </inertial>
  </link>
  <joint name="neck_shoulder_pan_joint" type="revolute">
    <parent link="neck_base_link"/>
    <child link="neck_shoulder_link"/>
    <origin rpy="0.0 0.0 0.0" xyz="0.0 0.0 0.1519"/>
    <axis xyz="0 0 1"/>
    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
    <limit effort="330.0" lower="-4.712388975" upper="4.712388975" velocity="2.16"/>
    <dynamics damping="0.0" friction="0.0"/>
  </joint>
  <link name="neck_shoulder_link">
    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
    <inertial>
      <mass value="2.0"/>
      <origin rpy="0 0 0" xyz="0.0 0.0 0.0"/>
      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
    </inertial>
  </link>
  <joint name="neck_shoulder_lift_joint" type="revolute">
    <parent link="neck_shoulder_link"/>
    <child link="neck_upper_arm_link"/>
    <origin rpy="0.0 1.570796325 0.0" xyz="0.0 0.1198 0.0"/>
    <axis xyz="0 1 0"/>
    <limit effort="330.0" lower="-3.76991118" upper="3.76991118" velocity="2.16"/>
    <dynamics damping="0.0" friction="0.0"/>
  </joint>
  <link name="neck_upper_arm_link">
    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
    <inertial>
      <mass value="3.42"/>
      <origin rpy="0 0 0" xyz="0.0 0.0 0.121825"/>
      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
    </inertial>
  </link>
  <joint name="neck_elbow_joint" type="revolute">
    <parent link="neck_upper_arm_link"/>
    <child link="neck_forearm_link"/>
    <origin rpy="0.0 0.0 0.0" xyz="0.0 -0.0925 0.24365"/>
    <axis xyz="0 1 0"/>
    <limit effort="150.0" lower="-3.76991118" upper="3.76991118" velocity="3.15"/>
    <dynamics damping="0.0" friction="0.0"/>
  </joint>
  <link name="neck_forearm_link">
    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
    <inertial>
      <mass value="1.26"/>
      <origin rpy="0 0 0" xyz="0.0 0.0 0.106625"/>
      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
    </inertial>
  </link>
  <joint name="neck_wrist_1_joint" type="revolute">
    <parent link="neck_forearm_link"/>
    <child link="neck_wrist_1_link"/>
    <origin rpy="0.0 1.570796325 0.0" xyz="0.0 0.0 0.21325"/>
    <axis xyz="0 1 0"/>
    <limit effort="54.0" lower="-4.084070445" upper="4.084070445" velocity="3.2"/>
    <dynamics damping="0.0" friction="0.0"/>
  </joint>
  <link name="neck_wrist_1_link">
    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
    <inertial>
      <mass value="0.8"/>
      <origin rpy="0 0 0" xyz="0.0 0.0 0.0"/>
      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
    </inertial>
  </link>
  <joint name="neck_wrist_2_joint" type="revolute">
    <parent link="neck_wrist_1_link"/>
    <child link="neck_wrist_2_link"/>
    <origin rpy="0.0 0.0 0.0" xyz="0.0 0.08505 0.0"/>
    <axis xyz="0 0 1"/>
    <limit effort="54.0" lower="-4.084070445" upper="4.084070445" velocity="3.2"/>
    <dynamics damping="0.0" friction="0.0"/>
  </joint>
  <link name="neck_wrist_2_link">
    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
    <inertial>
      <mass value="0.8"/>
      <origin rpy="0 0 0" xyz="0.0 0.0 0.0"/>
      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
    </inertial>
  </link>
  <joint name="neck_wrist_3_joint" type="revolute">
    <parent link="neck_wrist_2_link"/>
    <child link="neck_wrist_3_link"/>
    <origin rpy="0.0 0.0 0.0" xyz="0.0 0.0 0.08535"/>
    <axis xyz="0 1 0"/>
    <limit effort="54.0" lower="-3.14159265" upper="3.14159265" velocity="3.2"/>
    <dynamics damping="0.0" friction="0.0"/>
  </joint>
  <link name="neck_wrist_3_link">
    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
    <inertial>
      <mass value="0.35"/>
      <origin rpy="0 0 0" xyz="0.0 0.0 0.0"/>
      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
    </inertial>
  </link>
  <joint name="neck_ee_fixed_joint" type="fixed">
    <parent link="neck_wrist_3_link"/>
    <child link="neck_ee_link"/>
    <origin rpy="0.0 0.0 1.570796325" xyz="0.0 0.0819 0.0"/>
  </joint>
  <link name="neck_ee_link">
    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
  </link>
  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
  <link name="neck_base"/>
  <joint name="neck_base_link-base_fixed_joint" type="fixed">
    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
    <origin rpy="0 0 -3.14159265" xyz="0 0 0"/>
    <parent link="neck_base_link"/>
    <child link="neck_base"/>
  </joint>
  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
  <link name="neck_tool0"/>
  <joint name="neck_wrist_3_link-tool0_fixed_joint" type="fixed">
    <origin rpy="-1.570796325 0 0" xyz="0 0.0819 0"/>
    <parent link="neck_wrist_3_link"/>
    <child link="neck_tool0"/>
  </joint>
  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
  <joint name="neck_adapter_iso50_kinect2_joint" type="fixed">
    <origin rpy="0 0 -1.570795" xyz="0 0 0"/>
    <parent link="neck_tool0"/>
    <child link="neck_adapter_iso50_kinect2_frame_in"/>
  </joint>
  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
  <link name="neck_adapter_iso50_kinect2_frame_in">
    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
  </link>
  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
  <link name="neck_adapter_iso50_kinect2_frame_out"/>
  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
  <joint name="neck_adapter_iso50_kinect2_trans_frame_out" type="fixed">
    <origin rpy="0 0 0" xyz="0 0 0.020"/>
    <parent link="neck_adapter_iso50_kinect2_frame_in"/>
    <child link="neck_adapter_iso50_kinect2_frame_out"/>
    <axis xyz="0 0 0"/>
  </joint>
  <joint name="neck_joint_end" type="prismatic">
    <pose rpy="0 0 0" xyz="0 0 0"/>
    <parent link="neck_tool0"/>
    <child link="neck_look_target"/>
    <limit effort="1000.0" lower="0" upper="1.5" velocity="0.5"/>
    <origin rpy="-1.5708 0 0" xyz="0 0.01 0"/>
    <axis xyz="0 0 1"/>
  </joint>
  <link name="neck_look_target">
    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
  </link>
  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
  <joint name="head_mount_kinect2_in_joint" type="fixed">
    <origin rpy="-1.570795 0 1.570795" xyz="-0.02 0.10 0.02"/>
    <parent link="neck_adapter_iso50_kinect2_frame_out"/>
    <child link="head_mount_kinect2_rgb_optical_frame"/>
  </joint>
  <link name="head_mount_kinect2_rgb_optical_frame">
    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
  </link>
  <joint name="shoulder_kinect_joint" type="fixed">
    <origin rpy="0.01708077682636155 0.0085798647123734 -0.00929470452726490" xyz="0.0405394 -0.52064754 1.47001"/>
    <parent link="base_link"/>
    <child link="shoulder_kinect_link"/>
  </joint>
  <link name="shoulder_kinect_link">
    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
  </link>
  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
  <joint name="torso_joint" type="fixed">
    <origin rpy="0 0 0" xyz="0 0.065 0.41"/>
    <parent link="base_link"/>
    <child link="torso_base_link"/>
  </joint>
  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
  <link name="torso_base_link">
    <inertial>
      <origin rpy="0 0 0" xyz="0.0307745199844149 -0.285 0.513294719377322"/>
      <mass value="3.82694041846288"/>
      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
    </inertial>
    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
  </link>
  <link name="triangle_base_link">
    <inertial>
      <origin rpy="0 0 0" xyz="-0.302419226632933 -0.181352787411384 -0.0325004871109191"/>
      <mass value="7.36699467665114"/>
      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
    </inertial>
    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
  </link>
  <joint name="triangle_base_joint" type="prismatic">
    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
    <origin rpy="0 0 0" xyz="0.0786889663592487 0.0986351579738104 0.996332096493862"/>
    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
    <parent link="base_link"/>
    <child link="triangle_base_link"/>
    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
    <limit effort="0" lower="-0.586" upper="0" velocity="0.02"/>
    <axis xyz="0 0 1"/>
    <calibration rising="0.0"/>
  </joint>
  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
  <link name="triangle_left_arm_link"/>
  <joint name="triangle_left_arm_joint" type="fixed">
    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
    <origin rpy="1.046186267441739 0.005429697608281147 3.1340705895651766" xyz="0.134209 -0.240707 0.181709"/>
    <parent link="triangle_base_link"/>
    <child link="triangle_left_arm_link"/>
    <axis xyz="0 0 0"/>
  </joint>
  <link name="triangle_right_arm_link"/>
  <joint name="triangle_right_arm_joint" type="fixed">
    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
    <origin rpy="1.0482088349514576 -0.00542969760828114 -0.0075220640246236" xyz="0.133262 -0.366684 0.181581"/>
    <parent link="triangle_base_link"/>
    <child link="triangle_right_arm_link"/>
    <axis xyz="0 0 0"/>
  </joint>
  <joint name="triangle_left_arm_link_left_arm_base_joint" type="fixed">
    <origin rpy="0 0 1.047198" xyz="0 0 0"/>
    <parent link="triangle_left_arm_link"/>
    <child link="calib_left_arm_base_link"/>
  </joint>
  <link name="calib_left_arm_base_link">
    <inertial>
      <mass value="2.0"/>
      <origin rpy="0 0 0" xyz="0 0 0.055"/>
      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
    </inertial>
    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
  </link>
  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
  <joint name="left_arm_0_joint" type="revolute">
    <origin rpy="0 0 0" xyz="0 0 0.11"/>
    <axis xyz="0 0 1"/>
    <limit effort="204" lower="-2.61799387799" upper="2.61799387799" velocity="1.91986217719"/>
    <safety_controller k_position="100" k_velocity="2" soft_lower_limit="-2.58308729295" soft_upper_limit="2.58308729295"/>
    <dynamics damping="0.1"/>
    <calibration rising="0.0"/>
    <parent link="calib_left_arm_base_link"/>
    <child link="left_arm_1_link"/>
  </joint>
  <link name="left_arm_1_link">
    <inertial>
      <mass value="2.0"/>
      <origin rpy="0 0 0" xyz="0 0 0.130"/>
      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
    </inertial>
    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
  </link>
  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
  <joint name="left_arm_1_joint" type="revolute">
    <origin rpy="0 0 0" xyz="0 0 0.20"/>
    <axis xyz="0 -1 0"/>
    <limit effort="306" lower="-1.86750229963" upper="1.86750229963" velocity="1.91986217719"/>
    <safety_controller k_position="100" k_velocity="2" soft_lower_limit="-1.83259571459" soft_upper_limit="1.83259571459"/>
    <dynamics damping="0.1"/>
    <calibration rising="0.0"/>
    <parent link="left_arm_1_link"/>
    <child link="left_arm_2_link"/>
  </joint>
  <link name="left_arm_2_link">
    <inertial>
      <mass value="2.0"/>
      <origin rpy="0 0 0" xyz="0 0.06 0.07"/>
      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
    </inertial>
    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
  </link>
  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
  <joint name="left_arm_2_joint" type="revolute">
    <origin rpy="0 0 0" xyz="0 0 0.20"/>
    <axis xyz="0 0 1"/>
    <limit effort="204" lower="-2.61799387799" upper="2.61799387799" velocity="2.26892802759"/>
    <safety_controller k_position="100" k_velocity="2" soft_lower_limit="-2.58308729295" soft_upper_limit="2.58308729295"/>
    <dynamics damping="0.1"/>
    <calibration rising="0.0"/>
    <parent link="left_arm_2_link"/>
    <child link="left_arm_3_link"/>
  </joint>
  <link name="left_arm_3_link">
    <inertial>
      <mass value="2.0"/>
      <origin rpy="0 0 0" xyz="0 0.06 0.130"/>
      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
    </inertial>
    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
  </link>
  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
  <joint name="left_arm_3_joint" type="revolute">
    <origin rpy="0 0 0" xyz="0 0 0.20"/>
    <axis xyz="0 1 0"/>
    <limit effort="306" lower="-1.86750229963" upper="1.86750229963" velocity="2.26892802759"/>
    <safety_controller k_position="100" k_velocity="2" soft_lower_limit="-1.83259571459" soft_upper_limit="1.83259571459"/>
    <dynamics damping="0.1"/>
    <calibration rising="0.0"/>
    <parent link="left_arm_3_link"/>
    <child link="left_arm_4_link"/>
  </joint>
  <link name="left_arm_4_link">
    <inertial>
      <mass value="2.0"/>
      <origin rpy="0 0 0" xyz="0 -0.06 0.07"/>
      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
    </inertial>
    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
  </link>
  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
  <joint name="left_arm_4_joint" type="revolute">
    <origin rpy="0 0 0" xyz="0 0 0.20"/>
    <axis xyz="0 0 1"/>
    <limit effort="204" lower="-2.61799387799" upper="2.61799387799" velocity="2.26892802759"/>
    <safety_controller k_position="100" k_velocity="2" soft_lower_limit="-2.58308729295" soft_upper_limit="2.58308729295"/>
    <dynamics damping="0.1"/>
    <calibration rising="0.0"/>
    <parent link="left_arm_4_link"/>
    <child link="left_arm_5_link"/>
  </joint>
  <link name="left_arm_5_link">
    <inertial>
      <mass value="2.0"/>
      <origin rpy="0 0 0" xyz="0 0 0.124"/>
      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
    </inertial>
    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
  </link>
  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
  <joint name="left_arm_5_joint" type="revolute">
    <origin rpy="0 0 0" xyz="0 0 0.19"/>
    <axis xyz="0 -1 0"/>
    <limit effort="306" lower="-2.00712863979" upper="2.00712863979" velocity="3.14159265359"/>
    <safety_controller k_position="100" k_velocity="2" soft_lower_limit="-1.97222205475" soft_upper_limit="1.97222205475"/>
    <dynamics damping="0.1"/>
    <calibration rising="0.0"/>
    <parent link="left_arm_5_link"/>
    <child link="left_arm_6_link"/>
  </joint>
  <link name="left_arm_6_link">
    <inertial>
      <mass value="2.0"/>
      <origin rpy="0 0 0" xyz="0 0 0.0625"/>
      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
    </inertial>
    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
  </link>
  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
  <joint name="left_arm_6_joint" type="revolute">
    <origin rpy="0 0 0" xyz="0 0 0"/>
    <axis xyz="0 0 1"/>
    <limit effort="204" lower="-2.61799387799" upper="2.61799387799" velocity="3.14159265359"/>
    <safety_controller k_position="100" k_velocity="2" soft_lower_limit="-2.58308729295" soft_upper_limit="2.58308729295"/>
    <dynamics damping="0.1"/>
    <calibration rising="0.0"/>
    <parent link="left_arm_6_link"/>
    <child link="left_arm_7_link"/>
  </joint>
  <link name="left_arm_7_link">
    <inertial>
      <mass value="2.0"/>
      <origin xyz="0 0 0"/>
      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
    </inertial>
    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
  </link>
  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
  <joint name="left_arm_flange_joint" type="fixed">
    <origin rpy="0 0 0" xyz="0 0 0.078"/>
    <parent link="left_arm_7_link"/>
    <child link="left_arm_flange_link"/>
  </joint>
  <link name="left_arm_flange_link">
    <inertial>
      <mass value="0.5"/>
      <origin rpy="0 0 0" xyz="0 0 0"/>
      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
    </inertial>
  </link>
  <joint name="left_arm_arm_cabling_adaptor_joint" type="fixed">
    <origin rpy="0 0 0" xyz="0 0 0.01"/>
    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
    <parent link="left_arm_flange_link"/>
    <child link="left_arm_cabling_adaptor_link"/>
  </joint>
  <link name="left_arm_cabling_adaptor_link">
    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
  </link>
  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
  <joint name="left_arm_adapter_iso50_kms40_joint" type="fixed">
    <origin rpy="0 0 3.14159265359" xyz="0 0 0"/>
    <parent link="left_arm_cabling_adaptor_link"/>
    <child link="left_arm_adapter_iso50_kms40_frame_in"/>
  </joint>
  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
  <link name="left_arm_adapter_iso50_kms40_frame_in">
    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
  </link>
  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
  <link name="left_arm_adapter_iso50_kms40_frame_out"/>
  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
  <joint name="left_arm_adapter_iso50_kms40_trans_frame_out" type="fixed">
    <origin rpy="0 0 0" xyz="0 0 0.016"/>
    <parent link="left_arm_adapter_iso50_kms40_frame_in"/>
    <child link="left_arm_adapter_iso50_kms40_frame_out"/>
    <axis xyz="0 0 0"/>
  </joint>
  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
  <joint name="left_arm_kms40_joint" type="fixed">
    <origin rpy="0 0 0" xyz="0 0 0"/>
    <parent link="left_arm_adapter_iso50_kms40_frame_out"/>
    <child link="left_arm_kms40_frame_in"/>
  </joint>
  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
  <link name="left_arm_kms40_frame_in">
    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
  </link>
  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
  <link name="left_arm_kms40_frame_out"/>
  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
  <joint name="left_arm_kms40_trans_frame_out" type="fixed">
    <origin rpy="0 0 0" xyz="0 0 0.027"/>
    <parent link="left_arm_kms40_frame_in"/>
    <child link="left_arm_kms40_frame_out"/>
    <axis xyz="0 0 0"/>
  </joint>
  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
  <joint name="left_arm_adapter_kms40_fwk050_in_joint" type="fixed">
    <origin rpy="0 0 0" xyz="0 0 0"/>
    <parent link="left_arm_kms40_frame_out"/>
    <child link="left_arm_adapter_kms40_fwk050_frame_in"/>
  </joint>
  <link name="left_arm_adapter_kms40_fwk050_frame_in">
    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
  </link>
  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
  <link name="left_arm_adapter_kms40_fwk050_frame_out"/>
  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
  <joint name="left_arm_adapter_kms40_fwk050_trans_frame_out" type="fixed">
    <origin rpy="0 0 0" xyz="0 0 0.01"/>
    <parent link="left_arm_adapter_kms40_fwk050_frame_in"/>
    <child link="left_arm_adapter_kms40_fwk050_frame_out"/>
    <axis xyz="0 0 0"/>
  </joint>
  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
  <joint name="left_arm_fwk_fwa_050_in_joint" type="fixed">
    <origin rpy="0 0 0" xyz="0 0 0"/>
    <parent link="left_arm_adapter_kms40_fwk050_frame_out"/>
    <child link="left_arm_fwk_fwa_050_frame_in"/>
  </joint>
  <link name="left_arm_fwk_fwa_050_frame_in">
    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
  </link>
  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
  <link name="left_arm_fwk_fwa_050_frame_out"/>
  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
  <joint name="left_arm_fwk_fwa_050_trans_frame_out" type="fixed">
    <origin rpy="0 0 0" xyz="0 0 0.0141"/>
    <parent link="left_arm_fwk_fwa_050_frame_in"/>
    <child link="left_arm_fwk_fwa_050_frame_out"/>
    <axis xyz="0 0 0"/>
  </joint>
  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
  <joint name="left_arm_adapter_fwa050_wsg50_in_joint" type="fixed">
    <origin rpy="0 0 0" xyz="0 0 0.0"/>
    <parent link="left_arm_fwk_fwa_050_frame_out"/>
    <child link="left_arm_adapter_fwa050_wsg50_frame_in"/>
  </joint>
  <link name="left_arm_adapter_fwa050_wsg50_frame_in">
    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
  </link>
  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
  <link name="left_arm_adapter_fwa050_wsg50_frame_out"/>
  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
  <joint name="left_arm_adapter_fwa050_wsg50_trans_frame_out" type="fixed">
    <origin rpy="0 0 0" xyz="0 0 0.01"/>
    <parent link="left_arm_adapter_fwa050_wsg50_frame_in"/>
    <child link="left_arm_adapter_fwa050_wsg50_frame_out"/>
    <axis xyz="0 0 0"/>
  </joint>
  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
  <joint name="left_gripper_anterior_gripper_joint" type="fixed">
    <origin rpy="0 0 3.14159265359" xyz="0 0 0"/>
    <parent link="left_arm_adapter_fwa050_wsg50_frame_out"/>
    <child link="left_gripper_base_link"/>
  </joint>
  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
  <link name="left_gripper_base_link">
    <inertial>
      <mass value="0.25"/>
      <origin xyz="0 0 0"/>
      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
    </inertial>
    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
  </link>
  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
  <joint name="left_gripper_base_gripper_left_joint" type="prismatic">
    <limit effort="1.0" lower="-0.055" upper="-0.0027" velocity="0.42"/>
    <origin rpy="0 0 0" xyz="0 0 0"/>
    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
    <parent link="left_gripper_base_link"/>
    <child link="left_gripper_gripper_left_link"/>
    <dynamics damping="100" friction="100"/>
    <axis xyz="1 0 0"/>
    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
  </joint>
  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
  <link name="left_gripper_gripper_left_link">
    <inertial>
      <mass value="0.1"/>
      <origin xyz="0 0 0"/>
      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
    </inertial>
    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
    <contact_coefficients kd="1.0" kp="1000.0" mu="0"/>
  </link>
  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
  <joint name="left_gripper_guide_joint_finger_left" type="fixed">
    <origin rpy="0 0 0" xyz="0 0 0.023"/>
    <parent link="left_gripper_gripper_left_link"/>
    <child link="left_gripper_finger_left_link"/>
    <dynamics damping="100" friction="100"/>
    <axis xyz="1 0 0"/>
    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
  </joint>
  <link name="left_gripper_finger_left_link">
    <inertial>
      <mass value="0.1"/>
      <origin xyz="0 0 0"/>
      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
    </inertial>
    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
    <contact_coefficients kd="1.0" kp="1000.0" mu="0"/>
  </link>
  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
  <joint name="left_gripper_base_gripper_right_joint" type="prismatic">
    <limit effort="1.0" lower="0.0027" upper="0.055" velocity="0.42"/>
    <origin rpy="0 0 3.14159" xyz="0 0 0"/>
    <parent link="left_gripper_base_link"/>
    <child link="left_gripper_gripper_right_link"/>
    <axis xyz="-1 0 0"/>
    <dynamics damping="100" friction="100"/>
    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
  </joint>
  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
  <link name="left_gripper_gripper_right_link">
    <inertial>
      <mass value="0.1"/>
      <origin xyz="0 0 0"/>
      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
    </inertial>
    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
    <contact_coefficients kd="1.0" kp="1000.0" mu="0"/>
  </link>
  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
  <joint name="left_gripper_guide_joint_finger_right" type="fixed">
    <origin rpy="0 0 0" xyz="0 0 0.023"/>
    <parent link="left_gripper_gripper_right_link"/>
    <child link="left_gripper_finger_right_link"/>
  </joint>
  <link name="left_gripper_finger_right_link">
    <inertial>
      <mass value="0.1"/>
      <origin xyz="0 0 0"/>
      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
    </inertial>
    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
    <contact_coefficients kd="1.0" kp="1000.0" mu="0"/>
  </link>
  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
  <link name="left_gripper_tool_frame"/>
  <joint name="left_gripper_tool_frame_joint" type="fixed">
    <origin rpy="0 0 0" xyz="0 0 0.154"/>
    <parent link="left_gripper_base_link"/>
    <child link="left_gripper_tool_frame"/>
  </joint>
  <link name="left_wrist_optical_frame_x">
    <inertial>
      <mass value="1"/>
      <origin xyz="0 0 0"/>
      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
    </inertial>
    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
  </link>
  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
  <link name="limit_box">
    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
  </link>
  <joint name="fixed_box" type="fixed">
    <origin rpy="0.0 0.0 0.0" xyz="0.0 0.0 0.0"/>
    <parent link="base_link"/>
    <child link="limit_box"/>
  </joint>
  <link name="limit_box2">
    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
  </link>
  <joint name="fixed_box2" type="fixed">
    <origin rpy="0.0 0.0 0.0" xyz="0.0 0.0 0.0"/>
    <parent link="base_link"/>
    <child link="limit_box2"/>
  </joint>
  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
  <joint name="left_wrist_optical_joint_x" type="fixed">
    <origin rpy="0.007552 6.274592 3.141201" xyz="0.000836 -0.053028 0.073603"/>
    <parent link="left_gripper_base_link"/>
    <child link="left_wrist_optical_frame_x"/>
  </joint>
  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
  <link name="left_wrist_optical_frame">
    <inertial>
      <mass value="1"/>
      <origin xyz="0 0 0"/>
      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
    </inertial>
    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
  </link>
  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
  <joint name="left_wrist_optical_joint" type="fixed">
    <origin rpy="0.0 0.0 3.141519" xyz="0.0 0.0 0.0"/>
    <parent link="left_wrist_optical_frame_x"/>
    <child link="left_wrist_optical_frame"/>
  </joint>
  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
  <joint name="triangle_right_arm_link_right_arm_base_joint" type="fixed">
    <origin rpy="0 0 -1.047198" xyz="0 0 0"/>
    <parent link="triangle_right_arm_link"/>
    <child link="calib_right_arm_base_link"/>
  </joint>
  <link name="calib_right_arm_base_link">
    <inertial>
      <mass value="2.0"/>
      <origin rpy="0 0 0" xyz="0 0 0.055"/>
      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
    </inertial>
    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
  </link>
  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
  <joint name="right_arm_0_joint" type="revolute">
    <origin rpy="0 0 0" xyz="0 0 0.11"/>
    <axis xyz="0 0 1"/>
    <limit effort="204" lower="-2.61799387799" upper="2.61799387799" velocity="1.91986217719"/>
    <safety_controller k_position="100" k_velocity="2" soft_lower_limit="-2.58308729295" soft_upper_limit="2.58308729295"/>
    <dynamics damping="0.1"/>
    <calibration rising="0.0"/>
    <parent link="calib_right_arm_base_link"/>
    <child link="right_arm_1_link"/>
  </joint>
  <link name="right_arm_1_link">
    <inertial>
      <mass value="2.0"/>
      <origin rpy="0 0 0" xyz="0 0 0.130"/>
      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
    </inertial>
    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
  </link>
  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
  <joint name="right_arm_1_joint" type="revolute">
    <origin rpy="0 0 0" xyz="0 0 0.20"/>
    <axis xyz="0 -1 0"/>
    <limit effort="306" lower="-1.86750229963" upper="1.86750229963" velocity="1.91986217719"/>
    <safety_controller k_position="100" k_velocity="2" soft_lower_limit="-1.83259571459" soft_upper_limit="1.83259571459"/>
    <dynamics damping="0.1"/>
    <calibration rising="0.0"/>
    <parent link="right_arm_1_link"/>
    <child link="right_arm_2_link"/>
  </joint>
  <link name="right_arm_2_link">
    <inertial>
      <mass value="2.0"/>
      <origin rpy="0 0 0" xyz="0 0.06 0.07"/>
      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
    </inertial>
    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
  </link>
  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
  <joint name="right_arm_2_joint" type="revolute">
    <origin rpy="0 0 0" xyz="0 0 0.20"/>
    <axis xyz="0 0 1"/>
    <limit effort="204" lower="-2.61799387799" upper="2.61799387799" velocity="2.26892802759"/>
    <safety_controller k_position="100" k_velocity="2" soft_lower_limit="-2.58308729295" soft_upper_limit="2.58308729295"/>
    <dynamics damping="0.1"/>
    <calibration rising="0.0"/>
    <parent link="right_arm_2_link"/>
    <child link="right_arm_3_link"/>
  </joint>
  <link name="right_arm_3_link">
    <inertial>
      <mass value="2.0"/>
      <origin rpy="0 0 0" xyz="0 0.06 0.130"/>
      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
    </inertial>
    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
  </link>
  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
  <joint name="right_arm_3_joint" type="revolute">
    <origin rpy="0 0 0" xyz="0 0 0.20"/>
    <axis xyz="0 1 0"/>
    <limit effort="306" lower="-1.86750229963" upper="1.86750229963" velocity="2.26892802759"/>
    <safety_controller k_position="100" k_velocity="2" soft_lower_limit="-1.83259571459" soft_upper_limit="1.83259571459"/>
    <dynamics damping="0.1"/>
    <calibration rising="0.0"/>
    <parent link="right_arm_3_link"/>
    <child link="right_arm_4_link"/>
  </joint>
  <link name="right_arm_4_link">
    <inertial>
      <mass value="2.0"/>
      <origin rpy="0 0 0" xyz="0 -0.06 0.07"/>
      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
    </inertial>
    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
  </link>
  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
  <joint name="right_arm_4_joint" type="revolute">
    <origin rpy="0 0 0" xyz="0 0 0.20"/>
    <axis xyz="0 0 1"/>
    <limit effort="204" lower="-2.61799387799" upper="2.61799387799" velocity="2.26892802759"/>
    <safety_controller k_position="100" k_velocity="2" soft_lower_limit="-2.58308729295" soft_upper_limit="2.58308729295"/>
    <dynamics damping="0.1"/>
    <calibration rising="0.0"/>
    <parent link="right_arm_4_link"/>
    <child link="right_arm_5_link"/>
  </joint>
  <link name="right_arm_5_link">
    <inertial>
      <mass value="2.0"/>
      <origin rpy="0 0 0" xyz="0 0 0.124"/>
      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
    </inertial>
    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
  </link>
  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
  <joint name="right_arm_5_joint" type="revolute">
    <origin rpy="0 0 0" xyz="0 0 0.19"/>
    <axis xyz="0 -1 0"/>
    <limit effort="306" lower="-2.00712863979" upper="2.00712863979" velocity="3.14159265359"/>
    <safety_controller k_position="100" k_velocity="2" soft_lower_limit="-1.97222205475" soft_upper_limit="1.97222205475"/>
    <dynamics damping="0.1"/>
    <calibration rising="0.0"/>
    <parent link="right_arm_5_link"/>
    <child link="right_arm_6_link"/>
  </joint>
  <link name="right_arm_6_link">
    <inertial>
      <mass value="2.0"/>
      <origin rpy="0 0 0" xyz="0 0 0.0625"/>
      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
    </inertial>
    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
  </link>
  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
  <joint name="right_arm_6_joint" type="revolute">
    <origin rpy="0 0 0" xyz="0 0 0"/>
    <axis xyz="0 0 1"/>
    <limit effort="204" lower="-2.61799387799" upper="2.61799387799" velocity="3.14159265359"/>
    <safety_controller k_position="100" k_velocity="2" soft_lower_limit="-2.58308729295" soft_upper_limit="2.58308729295"/>
    <dynamics damping="0.1"/>
    <calibration rising="0.0"/>
    <parent link="right_arm_6_link"/>
    <child link="right_arm_7_link"/>
  </joint>
  <link name="right_arm_7_link">
    <inertial>
      <mass value="2.0"/>
      <origin xyz="0 0 0"/>
      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
    </inertial>
    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
  </link>
  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
  <joint name="right_arm_flange_joint" type="fixed">
    <origin rpy="0 0 0" xyz="0 0 0.078"/>
    <parent link="right_arm_7_link"/>
    <child link="right_arm_flange_link"/>
  </joint>
  <link name="right_arm_flange_link">
    <inertial>
      <mass value="0.5"/>
      <origin rpy="0 0 0" xyz="0 0 0"/>
      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
    </inertial>
  </link>
  <joint name="right_arm_arm_cabling_adaptor_joint" type="fixed">
    <origin rpy="0 0 0" xyz="0 0 0.01"/>
    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
    <parent link="right_arm_flange_link"/>
    <child link="right_arm_cabling_adaptor_link"/>
  </joint>
  <link name="right_arm_cabling_adaptor_link">
    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
  </link>
  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
  <joint name="right_arm_adapter_iso50_kms40_joint" type="fixed">
    <origin rpy="0 0 3.14159265359" xyz="0 0 0"/>
    <parent link="right_arm_cabling_adaptor_link"/>
    <child link="right_arm_adapter_iso50_kms40_frame_in"/>
  </joint>
  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
  <link name="right_arm_adapter_iso50_kms40_frame_in">
    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
  </link>
  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
  <link name="right_arm_adapter_iso50_kms40_frame_out"/>
  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
  <joint name="right_arm_adapter_iso50_kms40_trans_frame_out" type="fixed">
    <origin rpy="0 0 0" xyz="0 0 0.016"/>
    <parent link="right_arm_adapter_iso50_kms40_frame_in"/>
    <child link="right_arm_adapter_iso50_kms40_frame_out"/>
    <axis xyz="0 0 0"/>
  </joint>
  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
  <joint name="right_arm_kms40_joint" type="fixed">
    <origin rpy="0 0 0" xyz="0 0 0"/>
    <parent link="right_arm_adapter_iso50_kms40_frame_out"/>
    <child link="right_arm_kms40_frame_in"/>
  </joint>
  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
  <link name="right_arm_kms40_frame_in">
    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
  </link>
  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
  <link name="right_arm_kms40_frame_out"/>
  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
  <joint name="right_arm_kms40_trans_frame_out" type="fixed">
    <origin rpy="0 0 0" xyz="0 0 0.027"/>
    <parent link="right_arm_kms40_frame_in"/>
    <child link="right_arm_kms40_frame_out"/>
    <axis xyz="0 0 0"/>
  </joint>
  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
  <joint name="right_arm_adapter_kms40_fwk050_in_joint" type="fixed">
    <origin rpy="0 0 0" xyz="0 0 0"/>
    <parent link="right_arm_kms40_frame_out"/>
    <child link="right_arm_adapter_kms40_fwk050_frame_in"/>
  </joint>
  <link name="right_arm_adapter_kms40_fwk050_frame_in">
    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
  </link>
  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
  <link name="right_arm_adapter_kms40_fwk050_frame_out"/>
  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
  <joint name="right_arm_adapter_kms40_fwk050_trans_frame_out" type="fixed">
    <origin rpy="0 0 0" xyz="0 0 0.01"/>
    <parent link="right_arm_adapter_kms40_fwk050_frame_in"/>
    <child link="right_arm_adapter_kms40_fwk050_frame_out"/>
    <axis xyz="0 0 0"/>
  </joint>
  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
  <joint name="right_arm_fwk_fwa_050_in_joint" type="fixed">
    <origin rpy="0 0 0" xyz="0 0 0"/>
    <parent link="right_arm_adapter_kms40_fwk050_frame_out"/>
    <child link="right_arm_fwk_fwa_050_frame_in"/>
  </joint>
  <link name="right_arm_fwk_fwa_050_frame_in">
    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
  </link>
  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
  <link name="right_arm_fwk_fwa_050_frame_out"/>
  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
  <joint name="right_arm_fwk_fwa_050_trans_frame_out" type="fixed">
    <origin rpy="0 0 0" xyz="0 0 0.0141"/>
    <parent link="right_arm_fwk_fwa_050_frame_in"/>
    <child link="right_arm_fwk_fwa_050_frame_out"/>
    <axis xyz="0 0 0"/>
  </joint>
  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
  <joint name="right_arm_adapter_fwa050_wsg50_in_joint" type="fixed">
    <origin rpy="0 0 0" xyz="0 0 0.0"/>
    <parent link="right_arm_fwk_fwa_050_frame_out"/>
    <child link="right_arm_adapter_fwa050_wsg50_frame_in"/>
  </joint>
  <link name="right_arm_adapter_fwa050_wsg50_frame_in">
    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
  </link>
  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
  <link name="right_arm_adapter_fwa050_wsg50_frame_out"/>
  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
  <joint name="right_arm_adapter_fwa050_wsg50_trans_frame_out" type="fixed">
    <origin rpy="0 0 0" xyz="0 0 0.01"/>
    <parent link="right_arm_adapter_fwa050_wsg50_frame_in"/>
    <child link="right_arm_adapter_fwa050_wsg50_frame_out"/>
    <axis xyz="0 0 0"/>
  </joint>
  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
  <joint name="right_gripper_anterior_gripper_joint" type="fixed">
    <origin rpy="0 0 3.14159265359" xyz="0 0 0"/>
    <parent link="right_arm_adapter_fwa050_wsg50_frame_out"/>
    <child link="right_gripper_base_link"/>
  </joint>
  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
  <link name="right_gripper_base_link">
    <inertial>
      <mass value="0.25"/>
      <origin xyz="0 0 0"/>
      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
    </inertial>
    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
  </link>
  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
  <joint name="right_gripper_base_gripper_left_joint" type="prismatic">
    <limit effort="1.0" lower="-0.055" upper="-0.0027" velocity="0.42"/>
    <origin rpy="0 0 0" xyz="0 0 0"/>
    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
    <parent link="right_gripper_base_link"/>
    <child link="right_gripper_gripper_left_link"/>
    <dynamics damping="100" friction="100"/>
    <axis xyz="1 0 0"/>
    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
  </joint>
  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
  <link name="right_gripper_gripper_left_link">
    <inertial>
      <mass value="0.1"/>
      <origin xyz="0 0 0"/>
      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
    </inertial>
    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
    <contact_coefficients kd="1.0" kp="1000.0" mu="0"/>
  </link>
  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
  <joint name="right_gripper_guide_joint_finger_left" type="fixed">
    <origin rpy="0 0 0" xyz="0 0 0.023"/>
    <parent link="right_gripper_gripper_left_link"/>
    <child link="right_gripper_finger_left_link"/>
    <dynamics damping="100" friction="100"/>
    <axis xyz="1 0 0"/>
    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
  </joint>
  <link name="right_gripper_finger_left_link">
    <inertial>
      <mass value="0.1"/>
      <origin xyz="0 0 0"/>
      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
    </inertial>
    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
    <contact_coefficients kd="1.0" kp="1000.0" mu="0"/>
  </link>
  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
  <joint name="right_gripper_base_gripper_right_joint" type="prismatic">
    <limit effort="1.0" lower="0.0027" upper="0.055" velocity="0.42"/>
    <origin rpy="0 0 3.14159" xyz="0 0 0"/>
    <parent link="right_gripper_base_link"/>
    <child link="right_gripper_gripper_right_link"/>
    <axis xyz="-1 0 0"/>
    <dynamics damping="100" friction="100"/>
    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
  </joint>
  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
  <link name="right_gripper_gripper_right_link">
    <inertial>
      <mass value="0.1"/>
      <origin xyz="0 0 0"/>
      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
    </inertial>
    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
    <contact_coefficients kd="1.0" kp="1000.0" mu="0"/>
  </link>
  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
  <joint name="right_gripper_guide_joint_finger_right" type="fixed">
    <origin rpy="0 0 0" xyz="0 0 0.023"/>
    <parent link="right_gripper_gripper_right_link"/>
    <child link="right_gripper_finger_right_link"/>
  </joint>
  <link name="right_gripper_finger_right_link">
    <inertial>
      <mass value="0.1"/>
      <origin xyz="0 0 0"/>
      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
    </inertial>
    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
    <contact_coefficients kd="1.0" kp="1000.0" mu="0"/>
  </link>
  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
  <link name="right_gripper_tool_frame"/>
  <joint name="right_gripper_tool_frame_joint" type="fixed">
    <origin rpy="0 0 0" xyz="0 0 0.154"/>
    <parent link="right_gripper_base_link"/>
    <child link="right_gripper_tool_frame"/>
  </joint>
</robot>
