SemRoCo/giskardpy/test/urdfs/pr2.urdf

<?xml version="1.0" ?>
<robot name="pr2" xmlns:controller="http://playerstage.sourceforge.net/gazebo/xmlschema/#controller" xmlns:interface="http://playerstage.sourceforge.net/gazebo/xmlschema/#interface" xmlns:joint="http://playerstage.sourceforge.net/gazebo/xmlschema/#slider" xmlns:sensor="http://playerstage.sourceforge.net/gazebo/xmlschema/#sensor" xmlns:xacro="http://ros.org/wiki/xacro">
  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
  <link name="base_link">
    <inertial>
      <mass value="116"/>
      <origin xyz="-0.061 0.0 0.1465"/>
      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
    </inertial>
    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
  </link>
  <link name="base_footprint">
    <inertial>
      <mass value="1"/>
      <origin xyz="0.0 0.0 0.0"/>
      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
    </inertial>
    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
  </link>
  <joint name="base_footprint_joint" type="fixed">
    <parent link="base_footprint"/>
    <child link="base_link"/>
    <origin rpy="0.0 0.0 0.0" xyz="0.0 0.0 0.051"/>
  </joint>
  <link name="base_bellow_link">
    <inertial>
      <mass value="1"/>
      <origin xyz="0.0 0.0 0.0"/>
      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
    </inertial>
    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
  </link>
  <joint name="base_bellow_joint" type="fixed">
    <parent link="base_link"/>
    <child link="base_bellow_link"/>
    <origin rpy="0.0 0.0 0.0" xyz="-0.29 0.0 0.8"/>
  </joint>
  <joint name="base_laser_joint" type="fixed">
    <parent link="base_link"/>
    <child link="base_laser_link"/>
    <origin rpy="0.0 0.0 0.0" xyz="0.275 0.0 0.252"/>
    <axis xyz="0.0 1.0 0.0"/>
  </joint>
  <link name="base_laser_link" type="laser">
    <inertial>
      <mass value="0.001"/>
      <origin rpy="0.0 0.0 0.0" xyz="0.0 0.0 0.0"/>
      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
    </inertial>
  </link>
  <joint name="fl_caster_rotation_joint" type="continuous">
    <parent link="base_link"/>
    <child link="fl_caster_rotation_link"/>
    <origin rpy="0.0 0.0 0.0" xyz="0.2246 0.2246 0.0282"/>
    <axis xyz="0.0 0.0 1.0"/>
    <limit effort="6.5" velocity="10"/>
    <dynamics damping="1.0" friction="0.0"/>
    <safety_controller k_velocity="10"/>
    <calibration rising="-0.785398163397"/>
  </joint>
  <link name="fl_caster_rotation_link">
    <inertial>
      <mass value="3.473082"/>
      <origin xyz="0.0 0.0 0.07"/>
      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
    </inertial>
    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
  </link>
  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
  <joint name="fl_caster_l_wheel_joint" type="continuous">
    <parent link="fl_caster_rotation_link"/>
    <child link="fl_caster_l_wheel_link"/>
    <origin rpy="0.0 0.0 0.0" xyz="0.0 0.049 0.0"/>
    <axis xyz="0.0 1.0 0.0"/>
    <limit effort="7" velocity="15"/>
    <dynamics damping="1.0" friction="0.0"/>
    <safety_controller k_velocity="10"/>
  </joint>
  <link name="fl_caster_l_wheel_link">
    <inertial>
      <mass value="0.44036"/>
      <origin xyz="0.0 0.0 0.0"/>
      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
    </inertial>
    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
  </link>
  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
  <joint name="fl_caster_r_wheel_joint" type="continuous">
    <parent link="fl_caster_rotation_link"/>
    <child link="fl_caster_r_wheel_link"/>
    <origin rpy="0.0 0.0 0.0" xyz="0.0 -0.049 0.0"/>
    <axis xyz="0.0 1.0 0.0"/>
    <limit effort="7" velocity="15"/>
    <dynamics damping="1.0" friction="0.0"/>
    <safety_controller k_velocity="10"/>
  </joint>
  <link name="fl_caster_r_wheel_link">
    <inertial>
      <mass value="0.44036"/>
      <origin xyz="0.0 0.0 0.0"/>
      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
    </inertial>
    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
  </link>
  <joint name="fr_caster_rotation_joint" type="continuous">
    <parent link="base_link"/>
    <child link="fr_caster_rotation_link"/>
    <origin rpy="0.0 0.0 0.0" xyz="0.2246 -0.2246 0.0282"/>
    <axis xyz="0.0 0.0 1.0"/>
    <limit effort="6.5" velocity="10"/>
    <dynamics damping="1.0" friction="0.0"/>
    <safety_controller k_velocity="10"/>
    <calibration rising="-0.785398163397"/>
  </joint>
  <link name="fr_caster_rotation_link">
    <inertial>
      <mass value="3.473082"/>
      <origin xyz="0.0 0.0 0.07"/>
      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
    </inertial>
    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
  </link>
  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
  <joint name="fr_caster_l_wheel_joint" type="continuous">
    <parent link="fr_caster_rotation_link"/>
    <child link="fr_caster_l_wheel_link"/>
    <origin rpy="0.0 0.0 0.0" xyz="0.0 0.049 0.0"/>
    <axis xyz="0.0 1.0 0.0"/>
    <limit effort="7" velocity="15"/>
    <dynamics damping="1.0" friction="0.0"/>
    <safety_controller k_velocity="10"/>
  </joint>
  <link name="fr_caster_l_wheel_link">
    <inertial>
      <mass value="0.44036"/>
      <origin xyz="0.0 0.0 0.0"/>
      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
    </inertial>
    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
  </link>
  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
  <joint name="fr_caster_r_wheel_joint" type="continuous">
    <parent link="fr_caster_rotation_link"/>
    <child link="fr_caster_r_wheel_link"/>
    <origin rpy="0.0 0.0 0.0" xyz="0.0 -0.049 0.0"/>
    <axis xyz="0.0 1.0 0.0"/>
    <limit effort="7" velocity="15"/>
    <dynamics damping="1.0" friction="0.0"/>
    <safety_controller k_velocity="10"/>
  </joint>
  <link name="fr_caster_r_wheel_link">
    <inertial>
      <mass value="0.44036"/>
      <origin xyz="0.0 0.0 0.0"/>
      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
    </inertial>
    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
  </link>
  <joint name="bl_caster_rotation_joint" type="continuous">
    <parent link="base_link"/>
    <child link="bl_caster_rotation_link"/>
    <origin rpy="0.0 0.0 0.0" xyz="-0.2246 0.2246 0.0282"/>
    <axis xyz="0.0 0.0 1.0"/>
    <limit effort="6.5" velocity="10"/>
    <dynamics damping="1.0" friction="0.0"/>
    <safety_controller k_velocity="10"/>
    <calibration rising="2.35619449019"/>
  </joint>
  <link name="bl_caster_rotation_link">
    <inertial>
      <mass value="3.473082"/>
      <origin xyz="0.0 0.0 0.07"/>
      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
    </inertial>
    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
  </link>
  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
  <joint name="bl_caster_l_wheel_joint" type="continuous">
    <parent link="bl_caster_rotation_link"/>
    <child link="bl_caster_l_wheel_link"/>
    <origin rpy="0.0 0.0 0.0" xyz="0.0 0.049 0.0"/>
    <axis xyz="0.0 1.0 0.0"/>
    <limit effort="7" velocity="15"/>
    <dynamics damping="1.0" friction="0.0"/>
    <safety_controller k_velocity="10"/>
  </joint>
  <link name="bl_caster_l_wheel_link">
    <inertial>
      <mass value="0.44036"/>
      <origin xyz="0.0 0.0 0.0"/>
      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
    </inertial>
    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
  </link>
  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
  <joint name="bl_caster_r_wheel_joint" type="continuous">
    <parent link="bl_caster_rotation_link"/>
    <child link="bl_caster_r_wheel_link"/>
    <origin rpy="0.0 0.0 0.0" xyz="0.0 -0.049 0.0"/>
    <axis xyz="0.0 1.0 0.0"/>
    <limit effort="7" velocity="15"/>
    <dynamics damping="1.0" friction="0.0"/>
    <safety_controller k_velocity="10"/>
  </joint>
  <link name="bl_caster_r_wheel_link">
    <inertial>
      <mass value="0.44036"/>
      <origin xyz="0.0 0.0 0.0"/>
      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
    </inertial>
    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
  </link>
  <joint name="br_caster_rotation_joint" type="continuous">
    <parent link="base_link"/>
    <child link="br_caster_rotation_link"/>
    <origin rpy="0.0 0.0 0.0" xyz="-0.2246 -0.2246 0.0282"/>
    <axis xyz="0.0 0.0 1.0"/>
    <limit effort="6.5" velocity="10"/>
    <dynamics damping="1.0" friction="0.0"/>
    <safety_controller k_velocity="10"/>
    <calibration rising="2.35619449019"/>
  </joint>
  <link name="br_caster_rotation_link">
    <inertial>
      <mass value="3.473082"/>
      <origin xyz="0.0 0.0 0.07"/>
      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
    </inertial>
    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
  </link>
  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
  <joint name="br_caster_l_wheel_joint" type="continuous">
    <parent link="br_caster_rotation_link"/>
    <child link="br_caster_l_wheel_link"/>
    <origin rpy="0.0 0.0 0.0" xyz="0.0 0.049 0.0"/>
    <axis xyz="0.0 1.0 0.0"/>
    <limit effort="7" velocity="15"/>
    <dynamics damping="1.0" friction="0.0"/>
    <safety_controller k_velocity="10"/>
  </joint>
  <link name="br_caster_l_wheel_link">
    <inertial>
      <mass value="0.44036"/>
      <origin xyz="0.0 0.0 0.0"/>
      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
    </inertial>
    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
  </link>
  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
  <joint name="br_caster_r_wheel_joint" type="continuous">
    <parent link="br_caster_rotation_link"/>
    <child link="br_caster_r_wheel_link"/>
    <origin rpy="0.0 0.0 0.0" xyz="0.0 -0.049 0.0"/>
    <axis xyz="0.0 1.0 0.0"/>
    <limit effort="7" velocity="15"/>
    <dynamics damping="1.0" friction="0.0"/>
    <safety_controller k_velocity="10"/>
  </joint>
  <link name="br_caster_r_wheel_link">
    <inertial>
      <mass value="0.44036"/>
      <origin xyz="0.0 0.0 0.0"/>
      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
    </inertial>
    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
  </link>
  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
  <joint name="torso_lift_joint" type="prismatic">
    <parent link="base_link"/>
    <child link="torso_lift_link"/>
    <origin rpy="0.0 0.0 0.0" xyz="-0.05 0.0 0.739675"/>
    <axis xyz="0.0 0.0 1.0"/>
    <limit effort="10000" lower="0" upper="0.33" velocity="0.013"/>
    <dynamics damping="20000.0"/>
    <safety_controller k_position="100" k_velocity="2000000" soft_lower_limit="0.0115" soft_upper_limit="0.325"/>
    <calibration falling="0.00475"/>
  </joint>
  <link name="torso_lift_link">
    <inertial>
      <mass value="36.248046"/>
      <origin xyz="-0.1 0.0 -0.0885"/>
      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
    </inertial>
    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
  </link>
  <joint name="l_torso_lift_side_plate_joint" type="fixed">
    <parent link="torso_lift_link"/>
    <child link="l_torso_lift_side_plate_link"/>
    <origin rpy="0.0 0.0 0.0" xyz="0.0535 0.209285 0.176625"/>
  </joint>
  <link name="l_torso_lift_side_plate_link">
    <inertial>
      <mass value="0.1"/>
      <origin xyz="-0.0625 0.0 0.05"/>
      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
    </inertial>
  </link>
  <joint name="r_torso_lift_side_plate_joint" type="fixed">
    <parent link="torso_lift_link"/>
    <child link="r_torso_lift_side_plate_link"/>
    <origin rpy="0.0 0.0 0.0" xyz="0.0535 -0.209285 0.176625"/>
  </joint>
  <link name="r_torso_lift_side_plate_link">
    <inertial>
      <mass value="0.1"/>
      <origin xyz="-0.0625 0.0 0.05"/>
      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
    </inertial>
  </link>
  <link name="torso_lift_motor_screw_link">
    <inertial>
      <mass value="1"/>
      <origin rpy="0.0 0.0 0.0" xyz="0.0 0.0 0.0"/>
      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
    </inertial>
  </link>
  <joint name="torso_lift_motor_screw_joint" type="continuous">
    <parent link="base_link"/>
    <child link="torso_lift_motor_screw_link"/>
    <origin rpy="0.0 0.0 0.0" xyz="-0.15 0.0 0.7"/>
    <axis xyz="0.0 0.0 1.0"/>
    <dynamics damping="0.0001"/>
  </joint>
  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
  <joint name="imu_joint" type="fixed">
    <parent link="torso_lift_link"/>
    <child link="imu_link"/>
    <origin rpy="0.0 3.14159265359 0.0" xyz="-0.02977 -0.1497 0.164"/>
    <axis xyz="0.0 1.0 0.0"/>
  </joint>
  <link name="imu_link">
    <inertial>
      <mass value="0.001"/>
      <origin rpy="0.0 0.0 0.0" xyz="0.0 0.0 0.0"/>
      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
    </inertial>
  </link>
  <joint name="head_pan_joint" type="revolute">
    <parent link="torso_lift_link"/>
    <child link="head_pan_link"/>
    <origin rpy="0.0 0.0 0.0" xyz="-0.01707 0.0 0.38145"/>
    <axis xyz="0.0 0.0 1.0"/>
    <limit effort="2.645" lower="-3.007" upper="3.007" velocity="6"/>
    <dynamics damping="0.5"/>
    <safety_controller k_position="100" k_velocity="1.5" soft_lower_limit="-2.857" soft_upper_limit="2.857"/>
    <calibration rising="0.018065731275"/>
  </joint>
  <link name="head_pan_link">
    <inertial>
      <mass value="6.339"/>
      <origin rpy="0.0 0.0 0.0" xyz="0.010907 0.031693 0.090507"/>
      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
    </inertial>
    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
  </link>
  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
  <joint name="head_tilt_joint" type="revolute">
    <parent link="head_pan_link"/>
    <child link="head_tilt_link"/>
    <origin rpy="0.0 0.0 0.0" xyz="0.068 0.0 0.0"/>
    <axis xyz="0.0 1.0 0.0"/>
    <limit effort="18" lower="-0.471238" upper="1.39626" velocity="5"/>
    <dynamics damping="10.0"/>
    <safety_controller k_position="100" k_velocity="3" soft_lower_limit="-0.3712" soft_upper_limit="1.29626"/>
    <calibration falling="0"/>
  </joint>
  <link name="head_tilt_link">
    <inertial>
      <mass value="4.479"/>
      <origin rpy="0.0 0.0 0.0" xyz="0.001716 -0.019556 0.055002"/>
      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
    </inertial>
    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
  </link>
  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
  <joint name="head_plate_frame_joint" type="fixed">
    <parent link="head_tilt_link"/>
    <child link="head_plate_frame"/>
    <origin rpy="0.0 0.0 0.0" xyz="0.0232 0.0 0.0645"/>
  </joint>
  <link name="head_plate_frame">
    <inertial>
      <mass value="0.01"/>
      <origin rpy="0.0 0.0 0.0" xyz="0.0 0.0 0.0"/>
      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
    </inertial>
    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
  </link>
  <joint name="sensor_mount_frame_joint" type="fixed">
    <parent link="head_plate_frame"/>
    <child link="sensor_mount_link"/>
    <origin rpy="0.0 0.0 0.0" xyz="0.0 0.0 0.0"/>
  </joint>
  <link name="sensor_mount_link">
    <inertial>
      <mass value="0.05"/>
      <origin rpy="0.0 0.0 0.0" xyz="0.0 0.0 0.0"/>
      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
    </inertial>
    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
  </link>
  <joint name="high_def_frame_joint" type="fixed">
    <parent link="sensor_mount_link"/>
    <child link="high_def_frame"/>
    <origin rpy="-0.013344088743 -0.002157650878 0.00598407071" xyz="0.037305871189 -0.109084466748 0.051107786118"/>
  </joint>
  <link name="high_def_frame">
    <inertial>
      <mass value="0.01"/>
      <origin rpy="0.0 0.0 0.0" xyz="0.0 0.0 0.0"/>
      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
    </inertial>
  </link>
  <joint name="high_def_optical_frame_joint" type="fixed">
    <parent link="high_def_frame"/>
    <child link="high_def_optical_frame"/>
    <origin rpy="-1.57079632679 0.0 -1.57079632679" xyz="0.0 0.0 0.0"/>
  </joint>
  <link name="high_def_optical_frame">
    <inertial>
      <mass value="0.01"/>
      <origin rpy="0.0 0.0 0.0" xyz="0.0 0.0 0.0"/>
      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
    </inertial>
  </link>
  <joint name="double_stereo_frame_joint" type="fixed">
    <parent link="sensor_mount_link"/>
    <child link="double_stereo_link"/>
    <origin rpy="0.0 0.0 0.0" xyz="0.0 0.0 0.0"/>
  </joint>
  <link name="double_stereo_link">
    <inertial>
      <mass value="0.1"/>
      <origin rpy="0.0 0.0 0.0" xyz="0.0 0.0 0.0"/>
      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
    </inertial>
    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
  </link>
  <joint name="wide_stereo_frame_joint" type="fixed">
    <parent link="double_stereo_link"/>
    <child link="wide_stereo_link"/>
    <origin rpy="-0.006821150857 -0.011235489405 0.027024041802" xyz="0.039047869538 0.028900431683 0.045740529525"/>
  </joint>
  <link name="wide_stereo_link">
    <inertial>
      <mass value="0.1"/>
      <origin rpy="0.0 0.0 0.0" xyz="0.0 0.0 0.0"/>
      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
    </inertial>
  </link>
  <joint name="wide_stereo_optical_frame_joint" type="fixed">
    <parent link="wide_stereo_link"/>
    <child link="wide_stereo_optical_frame"/>
    <origin rpy="-1.57079632679 0.0 -1.57079632679" xyz="0.0 0.0 0.0"/>
  </joint>
  <link name="wide_stereo_optical_frame" type="camera"/>
  <joint name="wide_stereo_l_stereo_camera_frame_joint" type="fixed">
    <parent link="wide_stereo_link"/>
    <child link="wide_stereo_l_stereo_camera_frame"/>
    <origin rpy="0.0 0.0 0.0" xyz="0.0 0.0 0.0"/>
  </joint>
  <link name="wide_stereo_l_stereo_camera_frame">
    <inertial>
      <mass value="0.01"/>
      <origin xyz="0.0 0.0 0.0"/>
      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
    </inertial>
  </link>
  <joint name="wide_stereo_l_stereo_camera_optical_frame_joint" type="fixed">
    <parent link="wide_stereo_l_stereo_camera_frame"/>
    <child link="wide_stereo_l_stereo_camera_optical_frame"/>
    <origin rpy="-1.57079632679 0.0 -1.57079632679" xyz="0.0 0.0 0.0"/>
  </joint>
  <link name="wide_stereo_l_stereo_camera_optical_frame"/>
  <joint name="wide_stereo_r_stereo_camera_frame_joint" type="fixed">
    <parent link="wide_stereo_l_stereo_camera_frame"/>
    <child link="wide_stereo_r_stereo_camera_frame"/>
    <origin rpy="0.0 0.0 0.0" xyz="0.0 -0.09 0.0"/>
  </joint>
  <link name="wide_stereo_r_stereo_camera_frame">
    <inertial>
      <mass value="0.01"/>
      <origin xyz="0.0 0.0 0.0"/>
      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
    </inertial>
  </link>
  <joint name="wide_stereo_r_stereo_camera_optical_frame_joint" type="fixed">
    <parent link="wide_stereo_r_stereo_camera_frame"/>
    <child link="wide_stereo_r_stereo_camera_optical_frame"/>
    <origin rpy="-1.57079632679 0.0 -1.57079632679" xyz="0.0 0.0 0.0"/>
  </joint>
  <link name="wide_stereo_r_stereo_camera_optical_frame"/>
  <joint name="narrow_stereo_frame_joint" type="fixed">
    <parent link="double_stereo_link"/>
    <child link="narrow_stereo_link"/>
    <origin rpy="-0.006360148572 -0.007022640169 0.00538386839" xyz="0.036004211982 0.059339423616 0.046128460576"/>
  </joint>
  <link name="narrow_stereo_link">
    <inertial>
      <mass value="0.1"/>
      <origin rpy="0.0 0.0 0.0" xyz="0.0 0.0 0.0"/>
      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
    </inertial>
  </link>
  <joint name="narrow_stereo_optical_frame_joint" type="fixed">
    <parent link="narrow_stereo_link"/>
    <child link="narrow_stereo_optical_frame"/>
    <origin rpy="-1.57079632679 0.0 -1.57079632679" xyz="0.0 0.0 0.0"/>
  </joint>
  <link name="narrow_stereo_optical_frame" type="camera"/>
  <joint name="narrow_stereo_l_stereo_camera_frame_joint" type="fixed">
    <parent link="narrow_stereo_link"/>
    <child link="narrow_stereo_l_stereo_camera_frame"/>
    <origin rpy="0.0 0.0 0.0" xyz="0.0 0.0 0.0"/>
  </joint>
  <link name="narrow_stereo_l_stereo_camera_frame">
    <inertial>
      <mass value="0.01"/>
      <origin xyz="0.0 0.0 0.0"/>
      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
    </inertial>
  </link>
  <joint name="narrow_stereo_l_stereo_camera_optical_frame_joint" type="fixed">
    <parent link="narrow_stereo_l_stereo_camera_frame"/>
    <child link="narrow_stereo_l_stereo_camera_optical_frame"/>
    <origin rpy="-1.57079632679 0.0 -1.57079632679" xyz="0.0 0.0 0.0"/>
  </joint>
  <link name="narrow_stereo_l_stereo_camera_optical_frame"/>
  <joint name="narrow_stereo_r_stereo_camera_frame_joint" type="fixed">
    <parent link="narrow_stereo_l_stereo_camera_frame"/>
    <child link="narrow_stereo_r_stereo_camera_frame"/>
    <origin rpy="0.0 0.0 0.0" xyz="0.0 -0.09 0.0"/>
  </joint>
  <link name="narrow_stereo_r_stereo_camera_frame">
    <inertial>
      <mass value="0.01"/>
      <origin xyz="0.0 0.0 0.0"/>
      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
    </inertial>
  </link>
  <joint name="narrow_stereo_r_stereo_camera_optical_frame_joint" type="fixed">
    <parent link="narrow_stereo_r_stereo_camera_frame"/>
    <child link="narrow_stereo_r_stereo_camera_optical_frame"/>
    <origin rpy="-1.57079632679 0.0 -1.57079632679" xyz="0.0 0.0 0.0"/>
  </joint>
  <link name="narrow_stereo_r_stereo_camera_optical_frame"/>
  <joint name="projector_wg6802418_frame_joint" type="fixed">
    <parent link="head_plate_frame"/>
    <child link="projector_wg6802418_frame"/>
    <origin rpy="0.0 0.0 0.0" xyz="0.0 0.11 0.0546"/>
  </joint>
  <link name="projector_wg6802418_frame">
    <inertial>
      <mass value="0.01"/>
      <origin rpy="0.0 0.0 0.0" xyz="0.0 0.0 0.0"/>
      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
    </inertial>
  </link>
  <joint name="projector_wg6802418_child_frame_joint" type="fixed">
    <parent link="projector_wg6802418_frame"/>
    <child link="projector_wg6802418_child_frame"/>
    <origin rpy="0.0 -1.57079632679 0.0" xyz="0.0 0.0 0.0"/>
  </joint>
  <link name="projector_wg6802418_child_frame">
    <inertial>
      <mass value="0.01"/>
      <origin rpy="0.0 0.0 0.0" xyz="0.0 0.0 0.0"/>
      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
    </inertial>
  </link>
  <joint name="head_mount_joint" type="fixed">
    <parent link="head_plate_frame"/>
    <child link="head_mount_link"/>
    <origin rpy="0.0 0.0 0.0" xyz="-0.138 0.0 0.091"/>
  </joint>
  <link name="head_mount_link">
    <inertial>
      <mass value="0.1"/>
      <origin rpy="0.0 0.0 0.0" xyz="0.0 0.0 0.0"/>
      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
    </inertial>
    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
  </link>
  <joint name="head_mount_kinect_ir_joint" type="fixed">
    <parent link="head_mount_link"/>
    <child link="head_mount_kinect_ir_link"/>
    <origin rpy="0.0 0.0 0.0" xyz="-0.032267 0.0125 0.136453"/>
  </joint>
  <link name="head_mount_kinect_ir_link">
    <inertial>
      <mass value="0.1"/>
      <origin rpy="0.0 0.0 0.0" xyz="0.0 0.0 0.0"/>
      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
    </inertial>
    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
  </link>
  <joint name="head_mount_kinect_ir_optical_frame_joint" type="fixed">
    <parent link="head_mount_kinect_ir_link"/>
    <child link="head_mount_kinect_ir_optical_frame"/>
    <origin rpy="-1.57079632679 0.0 -1.57079632679" xyz="0.0 0.01 0.0"/>
  </joint>
  <link name="head_mount_kinect_ir_optical_frame"/>
  <joint name="head_mount_kinect_rgb_joint" type="fixed">
    <parent link="head_mount_kinect_ir_link"/>
    <child link="head_mount_kinect_rgb_link"/>
    <origin rpy="-0.009197234917 -0.03162989289 -0.000024986557" xyz="-0.016464580011 -0.024840302033 -0.015501555887"/>
  </joint>
  <link name="head_mount_kinect_rgb_link">
    <inertial>
      <mass value="0.1"/>
      <origin rpy="0.0 0.0 0.0" xyz="0.0 0.0 0.0"/>
      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
    </inertial>
    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
  </link>
  <joint name="head_mount_kinect_rgb_optical_frame_joint" type="fixed">
    <parent link="head_mount_kinect_rgb_link"/>
    <child link="head_mount_kinect_rgb_optical_frame"/>
    <origin rpy="-1.57079632679 0.0 -1.57079632679" xyz="0.0 0.0 0.0"/>
  </joint>
  <link name="head_mount_kinect_rgb_optical_frame"/>
  <joint name="head_mount_prosilica_joint" type="fixed">
    <parent link="head_mount_link"/>
    <child link="head_mount_prosilica_link"/>
    <origin rpy="0.0 0.0 0.0" xyz="-0.046457 0.0125 0.088921"/>
  </joint>
  <link name="head_mount_prosilica_link">
    <inertial>
      <mass value="0.1"/>
      <origin rpy="0.0 0.0 0.0" xyz="0.0 0.0 0.0"/>
      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
    </inertial>
    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
  </link>
  <joint name="head_mount_prosilica_optical_frame_joint" type="fixed">
    <parent link="head_mount_prosilica_link"/>
    <child link="head_mount_prosilica_optical_frame"/>
    <origin rpy="-1.57079632679 0.0 -1.57079632679" xyz="0.0 0.0 0.0"/>
  </joint>
  <link name="head_mount_prosilica_optical_frame"/>
  <joint name="laser_tilt_mount_joint" type="revolute">
    <parent link="torso_lift_link"/>
    <child link="laser_tilt_mount_link"/>
    <origin rpy="0.0 0.0 0.0" xyz="0.09893 0.0 0.227"/>
    <axis xyz="0.0 1.0 0.0"/>
    <limit effort="0.65" lower="-0.7854" upper="1.48353" velocity="10"/>
    <dynamics damping="0.008"/>
    <safety_controller k_position="100" k_velocity="0.05" soft_lower_limit="-0.7354" soft_upper_limit="1.43353"/>
    <calibration falling="-0.011570530833"/>
  </joint>
  <link name="laser_tilt_mount_link">
    <inertial>
      <mass value="0.591"/>
      <origin rpy="0.0 0.0 0.0" xyz="-0.001136 0.00167 -0.00713"/>
      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
    </inertial>
    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
  </link>
  <joint name="laser_tilt_joint" type="fixed">
    <parent link="laser_tilt_mount_link"/>
    <child link="laser_tilt_link"/>
    <origin rpy="0.0 0.0 -0.007935244203" xyz="0.0 0.0 0.028389479248"/>
    <axis xyz="0.0 1.0 0.0"/>
  </joint>
  <link name="laser_tilt_link" type="laser">
    <inertial>
      <mass value="0.001"/>
      <origin rpy="0.0 0.0 0.0" xyz="0.0 0.0 0.0"/>
      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
    </inertial>
  </link>
  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
  <joint name="r_shoulder_pan_joint" type="revolute">
    <parent link="torso_lift_link"/>
    <child link="r_shoulder_pan_link"/>
    <origin rpy="0.0 0.0 0.0" xyz="0.0 -0.188 0.0"/>
    <axis xyz="0.0 0.0 1.0"/>
    <limit effort="30" lower="-2.2853981634" upper="0.714601836603" velocity="2.088"/>
    <dynamics damping="10.0"/>
    <safety_controller k_position="100" k_velocity="10" soft_lower_limit="-2.1353981634" soft_upper_limit="0.564601836603"/>
    <calibration rising="-0.773059535784"/>
  </joint>
  <link name="r_shoulder_pan_link">
    <inertial>
      <mass value="25.799322"/>
      <origin rpy="0.0 0.0 0.0" xyz="-0.001201 0.024513 -0.098231"/>
      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
    </inertial>
    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
  </link>
  <joint name="r_shoulder_lift_joint" type="revolute">
    <parent link="r_shoulder_pan_link"/>
    <child link="r_shoulder_lift_link"/>
    <origin rpy="0.0 0.0 0.0" xyz="0.1 0.0 0.0"/>
    <axis xyz="0.0 1.0 0.0"/>
    <limit effort="30" lower="-0.5236" upper="1.3963" velocity="2.082"/>
    <dynamics damping="10.0"/>
    <safety_controller k_position="100" k_velocity="10" soft_lower_limit="-0.3536" soft_upper_limit="1.2963"/>
    <calibration falling="-0.009229695108"/>
  </joint>
  <link name="r_shoulder_lift_link">
    <inertial>
      <mass value="2.74988"/>
      <origin rpy="0.0 0.0 0.0" xyz="0.02195 -0.02664 -0.03127"/>
      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
    </inertial>
    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
  </link>
  <joint name="r_upper_arm_roll_joint" type="revolute">
    <parent link="r_shoulder_lift_link"/>
    <child link="r_upper_arm_roll_link"/>
    <origin rpy="0.0 0.0 0.0" xyz="0.0 0.0 0.0"/>
    <axis xyz="1.0 0.0 0.0"/>
    <limit effort="30" lower="-3.9" upper="0.8" velocity="3.27"/>
    <dynamics damping="0.1"/>
    <safety_controller k_position="100" k_velocity="2" soft_lower_limit="-3.75" soft_upper_limit="0.65"/>
    <calibration rising="-1.563595558753"/>
  </joint>
  <link name="r_upper_arm_roll_link">
    <inertial>
      <mass value="0.1"/>
      <origin rpy="0.0 0.0 0.0" xyz="0.0 0.0 0.0"/>
      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
    </inertial>
    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
  </link>
  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
  <joint name="r_upper_arm_joint" type="fixed">
    <parent link="r_upper_arm_roll_link"/>
    <child link="r_upper_arm_link"/>
    <origin rpy="0.0 0.0 0.0" xyz="0.0 0.0 0.0"/>
  </joint>
  <link name="r_upper_arm_link">
    <inertial>
      <mass value="6.01769"/>
      <origin xyz="0.21398 -0.01621 -0.0002"/>
      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
    </inertial>
    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
  </link>
  <joint name="r_forearm_roll_joint" type="continuous">
    <parent link="r_elbow_flex_link"/>
    <child link="r_forearm_roll_link"/>
    <origin rpy="0.0 0.0 0.0" xyz="0.0 0.0 0.0"/>
    <axis xyz="1.0 0.0 0.0"/>
    <limit effort="30" velocity="3.6"/>
    <dynamics damping="0.1"/>
    <safety_controller k_velocity="1"/>
    <calibration rising="-0.000169512108"/>
  </joint>
  <link name="r_forearm_roll_link">
    <inertial>
      <mass value="0.1"/>
      <origin xyz="0.0 0.0 0.0"/>
      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
    </inertial>
    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
  </link>
  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
  <joint name="r_elbow_flex_joint" type="revolute">
    <parent link="r_upper_arm_link"/>
    <child link="r_elbow_flex_link"/>
    <origin rpy="0.0 0.0 0.0" xyz="0.4 0.0 0.0"/>
    <axis xyz="0.0 1.0 0.0"/>
    <limit effort="30" lower="-2.3213" upper="0" velocity="3.3"/>
    <dynamics damping="1.0"/>
    <safety_controller k_position="100" k_velocity="3" soft_lower_limit="-2.1213" soft_upper_limit="-0.15"/>
    <calibration falling="-1.1606"/>
  </joint>
  <link name="r_elbow_flex_link">
    <inertial>
      <mass value="1.90327"/>
      <origin xyz="0.01014 0.00032 -0.01211"/>
      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
    </inertial>
    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
  </link>
  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
  <joint name="r_forearm_joint" type="fixed">
    <parent link="r_forearm_roll_link"/>
    <child link="r_forearm_link"/>
    <origin rpy="0.0 0.0 0.0" xyz="0.0 0.0 0.0"/>
  </joint>
  <link name="r_forearm_link">
    <inertial>
      <mass value="2.57968"/>
      <origin xyz="0.18791 -0.00017 -0.00912"/>
      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
    </inertial>
    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
  </link>
  <joint name="r_wrist_flex_joint" type="revolute">
    <parent link="r_forearm_link"/>
    <child link="r_wrist_flex_link"/>
    <origin rpy="0.0 0.0 0.0" xyz="0.321 0.0 0.0"/>
    <axis xyz="0.0 1.0 0.0"/>
    <limit effort="10" lower="-2.18" upper="0" velocity="3.078"/>
    <dynamics damping="0.1"/>
    <safety_controller k_position="20" k_velocity="4" soft_lower_limit="-2" soft_upper_limit="-0.1"/>
    <calibration falling="-0.526656726191"/>
  </joint>
  <link name="r_wrist_flex_link">
    <inertial>
      <mass value="0.61402"/>
      <origin xyz="-0.00157 0.0 -0.00075"/>
      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
    </inertial>
    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
  </link>
  <joint name="r_wrist_roll_joint" type="continuous">
    <parent link="r_wrist_flex_link"/>
    <child link="r_wrist_roll_link"/>
    <origin rpy="0.0 0.0 0.0" xyz="0.0 0.0 0.0"/>
    <axis xyz="1.0 0.0 0.0"/>
    <limit effort="10" velocity="3.6"/>
    <dynamics damping="0.1"/>
    <safety_controller k_velocity="2"/>
    <calibration rising="-1.489113074031"/>
  </joint>
  <link name="r_wrist_roll_link">
    <inertial>
      <mass value="0.1"/>
      <origin xyz="0.0 0.0 0.0"/>
      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
    </inertial>
    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
  </link>
  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
  <joint name="r_gripper_palm_joint" type="fixed">
    <parent link="r_wrist_roll_link"/>
    <child link="r_gripper_palm_link"/>
    <origin rpy="0.0 0.0 0.0" xyz="0.0 0.0 0.0"/>
  </joint>
  <link name="r_gripper_palm_link">
    <inertial>
      <mass value="0.58007"/>
      <origin rpy="0.0 0.0 0.0" xyz="0.06623 0.00053 -0.00119"/>
      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
    </inertial>
    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
  </link>
  <joint name="r_gripper_led_joint" type="fixed">
    <parent link="r_gripper_palm_link"/>
    <child link="r_gripper_led_frame"/>
    <origin rpy="0.0 0.0 0.0" xyz="0.0513 0.0 0.0244"/>
  </joint>
  <link name="r_gripper_led_frame"/>
  <joint name="r_gripper_motor_accelerometer_joint" type="fixed">
    <parent link="r_gripper_palm_link"/>
    <child link="r_gripper_motor_accelerometer_link"/>
    <origin rpy="0.0 0.0 0.0" xyz="0.0 0.0 0.0"/>
  </joint>
  <link name="r_gripper_motor_accelerometer_link">
    <inertial>
      <mass value="0.001"/>
      <origin rpy="0.0 0.0 0.0" xyz="0.0 0.0 0.0"/>
      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
    </inertial>
    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
  </link>
  <joint name="r_gripper_tool_joint" type="fixed">
    <parent link="r_gripper_palm_link"/>
    <child link="r_gripper_tool_frame"/>
    <origin rpy="0.0 0.0 0.0" xyz="0.18 0.0 0.0"/>
  </joint>
  <link name="r_gripper_tool_frame"/>
  <link name="r_gripper_motor_slider_link">
    <inertial>
      <mass value="0.01"/>
      <origin rpy="0.0 0.0 0.0" xyz="0.0 0.0 0.0"/>
      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
    </inertial>
  </link>
  <joint name="r_gripper_motor_slider_joint" type="prismatic">
    <parent link="r_gripper_palm_link"/>
    <child link="r_gripper_motor_slider_link"/>
    <origin rpy="0.0 0.0 0.0" xyz="0.16828 0.0 0.0"/>
    <axis xyz="1.0 0.0 0.0"/>
    <limit effort="1000" lower="-0.1" upper="0.1" velocity="0.2"/>
  </joint>
  <link name="r_gripper_motor_screw_link">
    <inertial>
      <mass value="0.01"/>
      <origin rpy="0.0 0.0 0.0" xyz="0.0 0.0 0.0"/>
      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
    </inertial>
  </link>
  <joint name="r_gripper_motor_screw_joint" type="continuous">
    <parent link="r_gripper_motor_slider_link"/>
    <child link="r_gripper_motor_screw_link"/>
    <origin rpy="0.0 0.0 0.0" xyz="0.0 0.0 0.0"/>
    <axis xyz="0.0 1.0 0.0"/>
    <dynamics damping="0.0001"/>
  </joint>
  <joint name="r_gripper_l_finger_joint" type="revolute">
    <parent link="r_gripper_palm_link"/>
    <child link="r_gripper_l_finger_link"/>
    <origin rpy="0.0 0.0 0.0" xyz="0.07691 0.01 0.0"/>
    <axis xyz="0.0 0.0 1.0"/>
    <limit effort="1000" lower="0" upper="0.548" velocity="0.5"/>
    <dynamics damping="0.02"/>
  </joint>
  <link name="r_gripper_l_finger_link">
    <inertial>
      <mass value="0.17126"/>
      <origin rpy="0.0 0.0 0.0" xyz="0.03598 0.0173 -0.00164"/>
      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
    </inertial>
    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
  </link>
  <joint name="r_gripper_r_finger_joint" type="revolute">
    <parent link="r_gripper_palm_link"/>
    <child link="r_gripper_r_finger_link"/>
    <origin rpy="0.0 0.0 0.0" xyz="0.07691 -0.01 0.0"/>
    <axis xyz="0.0 0.0 -1"/>
    <limit effort="1000" lower="0" upper="0.548" velocity="0.5"/>
    <dynamics damping="0.02"/>
  </joint>
  <link name="r_gripper_r_finger_link">
    <inertial>
      <mass value="0.17389"/>
      <origin rpy="0.0 0.0 0.0" xyz="0.03576 -0.01736 -0.00095"/>
      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
    </inertial>
    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
  </link>
  <joint name="r_gripper_l_finger_tip_joint" type="revolute">
    <parent link="r_gripper_l_finger_link"/>
    <child link="r_gripper_l_finger_tip_link"/>
    <origin rpy="0.0 0.0 0.0" xyz="0.09137 0.00495 0.0"/>
    <axis xyz="0.0 0.0 -1"/>
    <limit effort="1000" lower="0" upper="0.548" velocity="0.5"/>
    <dynamics damping="0.001"/>
  </joint>
  <link name="r_gripper_l_finger_tip_link">
    <inertial>
      <mass value="0.04419"/>
      <origin rpy="0.0 0.0 0.0" xyz="0.00423 0.00284 0.0"/>
      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
    </inertial>
    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
  </link>
  <joint name="r_gripper_r_finger_tip_joint" type="revolute">
    <parent link="r_gripper_r_finger_link"/>
    <child link="r_gripper_r_finger_tip_link"/>
    <origin rpy="0.0 0.0 0.0" xyz="0.09137 -0.00495 0.0"/>
    <axis xyz="0.0 0.0 1.0"/>
    <limit effort="1000" lower="0" upper="0.548" velocity="0.5"/>
    <dynamics damping="0.001"/>
  </joint>
  <link name="r_gripper_r_finger_tip_link">
    <inertial>
      <mass value="0.04419"/>
      <origin rpy="0.0 0.0 0.0" xyz="0.00423 -0.00284 0.0"/>
      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
    </inertial>
    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
  </link>
  <joint name="r_gripper_joint" type="prismatic">
    <parent link="r_gripper_r_finger_tip_link"/>
    <child link="r_gripper_l_finger_tip_frame"/>
    <origin rpy="0.0 0.0 0.0" xyz="0.0 0.0 0.0"/>
    <axis xyz="0.0 1.0 0.0"/>
    <limit effort="1000" lower="0" upper="0.09" velocity="0.2"/>
    <dynamics damping="10.0"/>
    <safety_controller k_position="20" k_velocity="5000" soft_lower_limit="-0.01" soft_upper_limit="0.088"/>
  </joint>
  <link name="r_gripper_l_finger_tip_frame"/>
  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
  <joint name="l_shoulder_pan_joint" type="revolute">
    <parent link="torso_lift_link"/>
    <child link="l_shoulder_pan_link"/>
    <origin rpy="0.0 0.0 0.0" xyz="0.0 0.188 0.0"/>
    <axis xyz="0.0 0.0 1.0"/>
    <limit effort="30" lower="-0.714601836603" upper="2.2853981634" velocity="2.088"/>
    <dynamics damping="10.0"/>
    <safety_controller k_position="100" k_velocity="10" soft_lower_limit="-0.564601836603" soft_upper_limit="2.1353981634"/>
    <calibration rising="0.815559365653"/>
  </joint>
  <link name="l_shoulder_pan_link">
    <inertial>
      <mass value="25.799322"/>
      <origin rpy="0.0 0.0 0.0" xyz="-0.001201 0.024513 -0.098231"/>
      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
    </inertial>
    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
  </link>
  <joint name="l_shoulder_lift_joint" type="revolute">
    <parent link="l_shoulder_pan_link"/>
    <child link="l_shoulder_lift_link"/>
    <origin rpy="0.0 0.0 0.0" xyz="0.1 0.0 0.0"/>
    <axis xyz="0.0 1.0 0.0"/>
    <limit effort="30" lower="-0.5236" upper="1.3963" velocity="2.082"/>
    <dynamics damping="10.0"/>
    <safety_controller k_position="100" k_velocity="10" soft_lower_limit="-0.3536" soft_upper_limit="1.2963"/>
    <calibration falling="-0.00761582293"/>
  </joint>
  <link name="l_shoulder_lift_link">
    <inertial>
      <mass value="2.74988"/>
      <origin rpy="0.0 0.0 0.0" xyz="0.02195 -0.02664 -0.03127"/>
      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
    </inertial>
    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
  </link>
  <joint name="l_upper_arm_roll_joint" type="revolute">
    <parent link="l_shoulder_lift_link"/>
    <child link="l_upper_arm_roll_link"/>
    <origin rpy="0.0 0.0 0.0" xyz="0.0 0.0 0.0"/>
    <axis xyz="1.0 0.0 0.0"/>
    <limit effort="30" lower="-0.8" upper="3.9" velocity="3.27"/>
    <dynamics damping="0.1"/>
    <safety_controller k_position="100" k_velocity="2" soft_lower_limit="-0.65" soft_upper_limit="3.75"/>
    <calibration rising="1.57179370496"/>
  </joint>
  <link name="l_upper_arm_roll_link">
    <inertial>
      <mass value="0.1"/>
      <origin rpy="0.0 0.0 0.0" xyz="0.0 0.0 0.0"/>
      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
    </inertial>
    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
  </link>
  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
  <joint name="l_upper_arm_joint" type="fixed">
    <parent link="l_upper_arm_roll_link"/>
    <child link="l_upper_arm_link"/>
    <origin rpy="0.0 0.0 0.0" xyz="0.0 0.0 0.0"/>
  </joint>
  <link name="l_upper_arm_link">
    <inertial>
      <mass value="6.01769"/>
      <origin xyz="0.21405 0.01658 -0.00057"/>
      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
    </inertial>
    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
  </link>
  <joint name="l_forearm_roll_joint" type="continuous">
    <parent link="l_elbow_flex_link"/>
    <child link="l_forearm_roll_link"/>
    <origin rpy="0.0 0.0 0.0" xyz="0.0 0.0 0.0"/>
    <axis xyz="1.0 0.0 0.0"/>
    <limit effort="30" velocity="3.6"/>
    <dynamics damping="0.1"/>
    <safety_controller k_velocity="1"/>
    <calibration rising="0.060757061899"/>
  </joint>
  <link name="l_forearm_roll_link">
    <inertial>
      <mass value="0.1"/>
      <origin xyz="0.0 0.0 0.0"/>
      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
    </inertial>
    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
  </link>
  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
  <joint name="l_elbow_flex_joint" type="revolute">
    <parent link="l_upper_arm_link"/>
    <child link="l_elbow_flex_link"/>
    <origin rpy="0.0 0.0 0.0" xyz="0.4 0.0 0.0"/>
    <axis xyz="0.0 1.0 0.0"/>
    <limit effort="30" lower="-2.3213" upper="0" velocity="3.3"/>
    <dynamics damping="1.0"/>
    <safety_controller k_position="100" k_velocity="3" soft_lower_limit="-2.1213" soft_upper_limit="-0.15"/>
    <calibration falling="-1.1606"/>
  </joint>
  <link name="l_elbow_flex_link">
    <inertial>
      <mass value="1.90327"/>
      <origin xyz="0.01014 0.00032 -0.01211"/>
      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
    </inertial>
    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
  </link>
  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
  <joint name="l_forearm_joint" type="fixed">
    <parent link="l_forearm_roll_link"/>
    <child link="l_forearm_link"/>
    <origin rpy="0.0 0.0 0.0" xyz="0.0 0.0 0.0"/>
  </joint>
  <link name="l_forearm_link">
    <inertial>
      <mass value="2.57968"/>
      <origin xyz="0.18791 -0.00017 -0.00912"/>
      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
    </inertial>
    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
  </link>
  <joint name="l_wrist_flex_joint" type="revolute">
    <parent link="l_forearm_link"/>
    <child link="l_wrist_flex_link"/>
    <origin rpy="0.0 0.0 0.0" xyz="0.321 0.0 0.0"/>
    <axis xyz="0.0 1.0 0.0"/>
    <limit effort="10" lower="-2.18" upper="0" velocity="3.078"/>
    <dynamics damping="0.1"/>
    <safety_controller k_position="20" k_velocity="4" soft_lower_limit="-2" soft_upper_limit="-0.1"/>
    <calibration falling="-0.537555026629"/>
  </joint>
  <link name="l_wrist_flex_link">
    <inertial>
      <mass value="0.61402"/>
      <origin xyz="-0.00157 0.0 -0.00075"/>
      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
    </inertial>
    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
  </link>
  <joint name="l_wrist_roll_joint" type="continuous">
    <parent link="l_wrist_flex_link"/>
    <child link="l_wrist_roll_link"/>
    <origin rpy="0.0 0.0 0.0" xyz="0.0 0.0 0.0"/>
    <axis xyz="1.0 0.0 0.0"/>
    <limit effort="10" velocity="3.6"/>
    <dynamics damping="0.1"/>
    <safety_controller k_velocity="2"/>
    <calibration rising="-1.481130190754"/>
  </joint>
  <link name="l_wrist_roll_link">
    <inertial>
      <mass value="0.1"/>
      <origin xyz="0.0 0.0 0.0"/>
      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
    </inertial>
    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
  </link>
  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
  <joint name="l_force_torque_adapter_joint" type="fixed">
    <parent link="l_wrist_roll_link"/>
    <child link="l_force_torque_adapter_link"/>
    <origin rpy="0.0 -1.570796326795 0.0" xyz="0.0356 0.0 0.0"/>
  </joint>
  <link name="l_force_torque_adapter_link"/>
  <joint name="l_force_torque_joint" type="fixed">
    <parent link="l_force_torque_adapter_link"/>
    <child link="l_force_torque_link"/>
    <origin rpy="0.0 0.0 1.221730476396" xyz="0.0 0.0 0.0"/>
  </joint>
  <link name="l_force_torque_link">
    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
  </link>
  <joint name="l_gripper_palm_joint" type="fixed">
    <parent link="l_force_torque_link"/>
    <child link="l_gripper_palm_link"/>
    <origin rpy="0.0 1.570796326795 -1.221730476396" xyz="0.0 0.0 0.0"/>
  </joint>
  <link name="l_gripper_palm_link">
    <inertial>
      <mass value="0.58007"/>
      <origin rpy="0.0 0.0 0.0" xyz="0.06623 0.00053 -0.00119"/>
      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
    </inertial>
    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
  </link>
  <joint name="l_gripper_led_joint" type="fixed">
    <parent link="l_gripper_palm_link"/>
    <child link="l_gripper_led_frame"/>
    <origin rpy="0.0 0.0 0.0" xyz="0.0513 0.0 0.0244"/>
  </joint>
  <link name="l_gripper_led_frame"/>
  <joint name="l_gripper_motor_accelerometer_joint" type="fixed">
    <parent link="l_gripper_palm_link"/>
    <child link="l_gripper_motor_accelerometer_link"/>
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
