SemRoCo/giskardpy/config/kmr_iiwa.yaml

general_options:
  debug: False # prints the behavior tree state in the terminal
  sample_period: 0.05 # time[s] between points of generated joint trajectory
  map_frame: map
  fill_velocity_values: True # due to a bug, the pr2 does not want the velocity values to be filled
  joint_vel_limit: # giskard will use the min of this number and limits from the urdf
    linear:
      default: 0.5
      odom_x_joint: 0.5
      odom_y_joint: 0.5
    angular:
      default: 0.5
      odom_z_joint: 0.5
  joint_acceleration_limit: # multiply your desired acc limit with sample period; experimental, don't touch
    linear:
      default: 100
    angular:
      default: 100
  joint_weights: # the planner prefers low weight joints to achieve solutions
    default: 0.01
    odom_x_joint: 0.05
    odom_y_joint: 0.05
    odom_z_joint: 0.05
qp_solver:
  nWSR: None # None results in a nWSR estimation thats fine most of the time
plugins:
  GoalReached:
    joint_convergence_threshold: 0.02 # when the velocities fall below this value, the planning succeeds
    window_size: 21 # in sample points, should be identical to WiggleCancel window_size
  VisualizationBehavior: # planning visualization through markers, slows planning down a little bit
    enabled: True
  CPIMarker: # contact visualization, slows planning down a little bit
    enabled: True
  PlotTrajectory: # plots the joint trajectory at the end of planning
    enabled: False
    velocity_threshold: 0.0 # only joints that exceed this velocity threshold will be added to the plot. Use a negative number if you want to include every joint
    scaling: 5.0 # determines how much the x axis is scaled with the length(time) of the trajectory
    normalize_position: False # centers the joint positions around 0 on the y axis
    tick_stride: 1.0 # the distance between ticks in the plot. if tick_stride <= 0 pyplot determines the ticks automatically 
  WiggleCancel: # cancels planning if high frequencies are detected in the trajectory
    amplitude_threshold: 0.55 # the amplitude of a frequency must exceed this threshold to be detected as wiggling
    window_size: 21 # size of the moving window of sample points
    frequency_range: 0.4 # must be in the range [0,1]. Only frequencies in the range [max_detectable_frequency * wiggle_frequency_range, max_detectable_frequency] are considered as wiggling. So a value of 0 means that every frequency with an amplitude above wiggle_detection_threshold is detected as wiggling and a value of 1 means that only the max_detectable_frequency can trigger a wiggle detection.      max_detectable_frequency = 1 / (2 * sample_period)
  tf_publisher:
    publish_attached_objects: True
    publish_world_objects: False
    tf_topic: /tf
reachability_check:
  sample_period: 0.5
  prismatic_velocity: 2.0
  continuous_velocity: 0.5
  revolute_velocity: 0.5
  other_velocity: 0.5
behavior_tree:
  tree_tick_rate: 0.1 # how often the tree updates. lower numbers increase responsiveness, but waste cpu time while idle
collision_avoidance:
  external_collision_avoidance:
    distance_thresholds: # external thresholds are per joint, they therefore count for all directly controlled links
      default:
        hard_threshold: 0.0 # at this distance in [cm] that can not be surpassed
        soft_threshold: 0.1 # robot links are pushed to that distance, but it can be overpowered with high weight constraints
      override: {}
    # each controlled joint gets pushed away from its X nearest objects
    # to reduce the runtime, you can set different values for joints that control end effectors
    number_of_repeller:
      default: 1
      end_effector_joints: 4
  self_collision_avoidance:
    distance_thresholds: # thresholds for self collision avoidance are set for each link pair
      default: &default # you can set variables and reuse them
        hard_threshold: 0.0 # at this distance in [cm] that can not be surpassed
        soft_threshold: 0.05 # robot links are pushed to that distance, but it can be overpowered with high weight constraints
      override: {}
        # examples, that don't have an affect:
    ignore: [] # list pairs of links that should be removed from the self collision avoidance
#    ignore: #example
#      - [base_link, l_upper_arm_link]
    add: [] # list pairs of links that should be added to the self collision matrix
    number_of_repeller: 1 # each movable joint gets pushed away from the X objects closest to it
