SemRoCo/giskardpy/(commit log)

2017-10-12 added urdf_import + first test
    [boxy.urdf]
2017-10-16 controller implementation based on adrians pull request
    [pointy.urdf, pointy_adrian.urdf]
2017-10-16 :unicorn: Create frame tree for robot from urdf
2017-10-17 :unicorn: Added new controller for moving an end effector to a position. Changed assignment of joint weights and adjusted pointy_bot to match interface. Fixed bugs in sympy_wrappers
2017-10-18 :muscle: Built matrix based on controlled joints not all robot observables. Removed unused parameters from QPBuilder's init
2017-10-19 removed some old files and added test for pr2 joint controller
    [pr2.urdf]
2017-10-23 :muscle: Added default weights for robot joints
2017-10-23 :unicorn: Extended new input system to include vec3 quaternions and frames
2017-10-23 :bug: Wrong superclass call in Frame3
2017-10-25 Added tests to compare differentiation speeds on affordance function
    [fetch.urdf]
2017-10-26 added new tests for eef controller
    [pointy.urdf, pointy_adrian.urdf]
2017-10-27 added missing urdf
    [2d_base_bot.urdf]
2017-10-30 added symengine wrappers and added sympy/symengine switch
2017-11-21 first version of giskard ros controller + bug fixes
    [fixed.urdf, iai_donbot.urdf]
2018-01-22 first real georg style cartesian controller
    [2d_base_bot.urdf, fixed.urdf]
2018-01-26 updated tests and fixed bugs
    [2d_base_bot.urdf]
2018-02-01 pr2 right arm benchmark
2018-02-01 made pr2 right arm benchmark shorter
2018-02-06 added cse to pr2 right arm example
2018-02-14 deleted v0.1
    [fetch.urdf]
2018-02-23 added jointstate input, print joint state output and main + some bug fixes
2018-03-05 Sketched object representations. So far, mirrors URDF representation of links for easy import/export.
2018-03-05 Added support for URDF generation for objects.
2018-03-05 Added default constructors to data types. Also sketched possible test cases for URDF generation.
2018-03-06 Added unit tests for URDF generation of objects.
2018-03-14 works with 1 arm at a time on pr2
2018-03-19 controller can now be assembled from multiple constraints
2018-05-11 init kinematic chains on demand kinda works
2018-05-14 Switched branch of giskardpy
2018-05-14 Correct dependency on urdfdom_py.
2018-05-14 joint state controller works
2018-05-15 Refactoring: Untangled confusion about spawning objects and robots from URDF strings and files.
2018-05-15 added script to init kinematic chains
2018-05-16 Started implementing attach_object().
2018-05-17 Fleshed out attaching and detaching of objects to robot.
2018-05-18 Refactoring: Added dedicated method to add ground plane to PyBulletWorld. No longer uses plane.urdf
2018-05-18 Cleaned up loaded robot URDFs from disc.
2018-05-22 fixed bug that caused joint goals to be ignored for all but the first goal
2018-05-24 Made sure old joint states and base pose are salvaged when re-spawning the robot in the PyBullet world.
2018-05-24 Correctly update self-collision matrix during attach and detach operations.
2018-05-24 Caught some corner cases in attaching and detaching of objects from robot.
2018-05-24 marged update and get_readings; giskard can now be interrupted during planning
2018-05-24 fixed joint state goals again
2018-05-25 Refactoring: JointStatePlugin now uses a conversion message for its input ROS message.
2018-05-25 Added support for adding and removing of articulated objects that get their state over an additional JointState topic.
2018-05-25 god_map.get_data now calls functions with self as parameter; continuous joints fixed
2018-05-25 added support for p_gain and max_speed for joint goals
2018-05-30 fixed bug that cause joint limits to be matched with the wrong joints
2018-05-30 fixed bug that caused insolvable exception to be raised if the goal is equal to the current state
2018-05-30 increased joint goal speed in python interface
2018-06-05 fixed some problems with the joint controller
2018-06-05 exposed nWSR, joint_convergence_threshold, wiggle_precision_threshold
2018-06-06 added fill velocity values parameter
2018-06-06 improved debug print on contact
2018-06-21 collision avoidance probably works for attached objects
2018-06-25 added prints when objects are added or removed, fixed bug that allowed object and attached objects of the same name
2018-06-25 fixed collision entries with attached objects
2018-06-29 Fixed dependency on urdfdom_py
2018-07-27 more tests and refactoring
    [2d_base_bot.urdf, boxy.urdf, fixed.urdf, iai_donbot.urdf, pointy.urdf, pr2.urdf]
2018-09-11 made godmap threadsafe (hopefully)
2018-10-08 added new sync state to clean up after interrupted planning; moved enable self collision param to interactive marker thingy
2018-10-11 existing objects can now be attached
2018-11-08 fixed deadlock when goal was interrupted
2018-11-27 fix for 18.04 urdf parser
2018-12-14 joint goal publisher
2019-01-14 added free symbols functionality back to symengine controller just in case .free_symbols leads to bugs
2019-01-29 increased default joint vel for tests
2019-01-29 fixed self collision avoidance for attached objects
2019-01-30 exposed default joint weight and fixed slerp
2019-01-30 default joint weight can be changed during runtime
2019-02-05 fixed attachment of existing objects
2019-02-05 printed behavior tree graph includes plugin hack
2019-02-08 fixed scripts to attach, add remove boxes and fixed spawning of meshobjects in pybullet
2019-02-19 started to refactor robot class
    [ground_plane.urdf, tiny_ball.urdf]
2019-02-22 removed debug print -- again
2019-03-01 implemented new URDFObject
2019-03-05 new world and world object classes and pybullet implementations of those
    [2d_base_bot.urdf]
2019-03-06 done with new urdf/worldobject and their pybullet implementations
2019-03-15 added more tests and bug fixes for new world and objects
    [ground_plane.urdf, tiny_ball.urdf]
2019-03-18 changed default joint weight for pr2 tests
2019-03-18 default joint weight and vel are read from god map
2019-03-20 fixed set joint state of non robot world objects
2019-03-27 added joint movement test for donbot
2019-03-28 added from object state constructor to urdf object
2019-03-28 fixed bug when object with the same name is attached twice
2019-04-11 sped up calculation of self collision matrix when attaching objects a bit
2019-05-07 added docu for joint position constraint
2019-05-07 joint movements work
2019-05-08 added plugin to publish tf for attached frames
2019-05-08 updated a test case
2019-05-13 replaced print with logmsg
2019-05-15 fixed marker scale of sphere and cylinder
2019-05-15 added test for items attached to both endeffectors
2019-05-22 added script that turns simple move base goals into joint goals
2019-05-22 added joint goal splitter
2019-05-22 stopping the state publisher thread properly
2019-05-24 added more debug prints when qp solver fails
2019-05-24 better debug prints on qp fail
2019-05-24 objects can be attached with continuous joint -- still buggy but nothing crashes
2019-05-27 continuous joint of attached object is now at the right position
2019-05-29 removed functionality to attach objects with non fixed joint again
2019-05-29 added constraint that simulates gravity influence on continuous joint
2019-06-03 traj splitter fills velocities and renamed some topics
2019-06-04 params are now stored in config yaml
    [ground_plane.urdf, tiny_ball.urdf]
2019-06-04 its now possible to set individual joint weights
2019-06-05 joint goal splitter arbitrary amount of clients
2019-06-05 Update joint_goal_splitter.py
    minor changes
2019-06-06 joint traj splitter now copies vel, acc and effort as well
2019-06-06 added renamed launch file for joint traj splitter
2019-06-06 reformatted joint traj splitter launch file
2019-06-07 fixed get_chain in urdf object
2019-06-14 made base joint state publisher executable
2019-06-18 fixed self collision avoidance if link b is not in chain to link a
2019-06-20 base to joint state publisher uses odometry instead of tf
2019-06-21 fixed base joint state publisher
2019-06-26 launchfiles for joint_goal_splitter
2019-07-03 correct hsr base joint names
2019-07-04 renamed hz to sample period
2019-07-09 added acceleration constraints and added possibility to define joint vel limits per joint
2019-07-10 bug fix in traj to joint states script
2019-07-17 updated constraints to take sample period into account
2019-07-26 increased default vel of joint goals
2019-07-26 added better debug printout to qp problem builder
2019-07-30 round position of attached object to make giskard more likely to load old controllers
2019-07-30 fixed bug where first point of traj was not the current joint state
2019-08-01 added print to wiggle detector
2019-08-29 fixes for melodic urdf parser
    [pr2.urdf]
2019-08-29 fix for 16.04 and 18.04 urdf parser
2019-10-25 joint trajectory splitter unit tests
    [holonomic_base.urdf]
2019-10-29 quick fix for reference bug with casadi
    [pr2_with_base.urdf]
2019-10-30 removed debug print
2019-11-05 external collisions per joint instead of per link
    [holonomic_base.urdf, pr2_with_base.urdf]
2019-11-07 fixed bug when attaching objects
2019-11-08 pr2 tests start joint traj splitter
2019-11-08 improved joint trajectory splitter prints
2019-11-19 bug fix in joint trajectory splitter
2019-12-16 fixed mimic joint
2019-12-20 added msg when objects are attached or detached
2019-12-20 added print when object gets attached, that doesnt exist yet
2019-12-30 added new donbot joint movement test
2019-12-30 fixed prints when modifying world
2019-12-30 fixed test urdf object
2020-01-13 fixed minor bug in joint position
2020-01-13 reformatted debug print code
2020-01-13 joint constraints with 0 weight dont get added to every goal anymore
2020-01-13 added get_movable_parent_joint back to urdf_object
2020-01-13 changed default velocity of cartesian orientation goals
2020-01-17 added weight function to joint symbols
2020-01-17 config file now supports separate limits for linear and angular joints
2020-01-20 split jointposition constraints into new with for each joint type
2020-01-23 fixed bug in self collision avoidance when base movement is not available
    [iai_donbot.urdf]
2020-01-27 success with joint goals
2020-01-28 fixed bug in joint velocity constraints
2020-01-30 renamed max speed to max velocity and added max acceleration parameter to constraints
2020-01-31 fixed merge fail of joint constraints
2020-01-31 added test for prismatic joint goal
2020-01-31 added joint goal check during test reset
2020-01-31 reduced weight of pr2 torso lift joint
2020-01-31 fixed weight function in primatic joint constraint
2020-02-03 removed debug constraints from joint position continuous
2020-02-07 reduced default cartesian orientation velocity limit
2020-02-10 fixed another mimic joint bug
2020-02-11 fix for new urdfparser-py version
2020-02-12 increased the number of self collision constraints based on the number of links attached to a controlled joint
2020-02-13 plugin goal reached now stops when there was a low velocity for a set amount of time, instead of stopping when its low for only one step
2020-02-27 replaced acceleration limit with velocity limit for orientation slerp constraint
2020-03-13 added linear velocity threshold to BasePointingForward constraints
2020-05-07 fixed bug in debug print
2020-06-01 included hard constraints in joint constraints
2020-06-08 added velocity limits to external collision avoidance
2020-06-10 added normalization factor for joint constraints
2020-06-26 Update launcher for boxy in real and sim The config is split only for different joint velocity caps, since simulation can be more reckless. Also simulation accepts more end-effectors to move via inte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
2020-06-29 Fix client topic to right arm
2020-06-30 Add observer for joint limits
2020-07-14 quick bug fix for case when preempt is requested, but there was no exception
2020-07-14 added optional goal joint state parameter to open and close constraints
2020-07-15 first try for constraint to avoid joint limits
2020-07-15 exposed some velocity limits and added test for milestone dishwasher
2020-07-20 Add calculation of hinge axis and some comments
2020-07-20 added prints when joints are out of bounds
2020-07-27 joint limit avoidance using linear termin in qp costfunction
2020-07-29 increased default joint weights for pr2
2020-07-29 fixed joint goal publisher
2020-07-29 added avoid joint limits constraint
2020-07-30 added print joint state script
2020-08-05 reduced pr2 joint convergence threshold
2020-08-12 reduced collision threshold for wheels
2020-08-12 giskard now always published the markers for the last joint state of the planned trajectory
2020-08-14 attached tf publisher now locks the god map until its done
2020-08-14 Add prototype for the CartesianPositionStraight constraint
    The code was copied from the CartesianPosition constraint and will
    be extended later.
2020-08-18 giskard now always published the markers for the last joint state of the planned trajectory; for real this time
2020-08-26 increased default weight of avoid joint limits to weight below collision avoidance and exposed its weight parameter
2020-08-28 dump state saves current/last goal and takes joint state from robot
2020-09-02 avoid joint limits weights now depend on distance to joint limits
2020-09-06 debug print uses csv
2020-09-21 added prints to loop detector
2020-09-21 improved shaking detection prints
2020-09-22 added prints when parsing goal message
2020-09-24 saving last joint state
2020-09-24 added cut off shaking option
2020-09-24 fixed printing of extrapolation exception
2020-09-28 added plugin to that appends 0 velocity at end of trajectory
2020-10-08 added debugging script that sends trajectory as joint state
2020-10-14 traj to joint state transforms odom goals
2020-10-14 added parameter to python interface to set different setter joint state for urdf objects
2020-11-02 fixed kmr iiwa config file
    [kmr_iiwa.yaml]
2020-11-10 added bowl 21
    [bowl_21.obj]
2020-11-19 fix wrong joint state after calculating collision matrix
2020-11-20 refactored joint_limits_observer.py
2020-11-27 publish world objects in attached_tf_publisher
2020-12-11 add: get joint_states to giskard_wrapper
2020-12-15 Removed Current_quaternion
2020-12-30 added memoize to get urdf str
2021-01-05 Fix some parameters
    Some of the parameters were switched which made some funny movements. Also
    the function set_straight_cart_goal replaces set_straight_translation_goal
    in the test because the latter leads to wiggling.
2021-02-25 qp problem builder autoamtically adds constraints to link velocity and acceleration
2021-02-26 joint goals work again
2021-03-04 [tfwrapper] added function to return full frame name
2021-03-11 [plugin_world_vis] adding of visual offsets on top of link frames
2021-03-12 fixed filtering in qp builder
2021-03-18 [urdf_object] methods to get visual origin and check if there is any
2021-03-18 [urdf-obj] minor
2021-03-18 [tfwrapper] throw KeyError if frame_name does not exist
2021-03-29 [plugin_world_vis] ignore vis of links if frames are not found in tf
2021-04-01 [constrains] create shakey with freq in range(4,11,1) (sampling with 20hz) and range(20,51,10) (sampling with 100hz)
2021-04-01 [constrains] and actually also works with freqs in the range(20,51,5) (with 100hz sampling rate)
2021-04-19 fixed weights of velocity constraints
2021-04-19 hand over sample period to qp problem builder
2021-04-22 [test_inter_pr2] adding of neglactable shaking test for cont jnts and noise_amplitudes for sample_rates of 0.01 or 0.05.
2021-04-29 [test] shaking only joint test
2021-06-14 sped up filtering
2021-06-18 separated constraints and velocity constraints
2021-06-29 fixed avoid joint limits constraint
2021-07-09 added velocity limits for cart constraints
2021-07-15 fixed bug where horizon function was set for position instead of velocity
2021-07-16 fixed but in kinematic sim
2021-07-27 added more prints
2021-08-06 added warning if joints are close during limits after qp infeasible exception
2021-08-09 logging will print, when ros is not running
2021-08-11 create a class for joint state
2021-08-12 added JointPositionLimit
2021-08-16 fixed test urdf object and test world
2021-08-16 fixed test pybullet world
    [iai_donbot.urdf]
2021-08-16 fixed joint traj splitter tests
2021-08-19 [qp_solver_cplex] small fix for print_debug
2021-08-19 [qp_solver_cplex] removed unsused print stmt
2021-08-26 [world/plugin_pybullet] decoupling removing and attaching in world.py and instead doing it in plugin_pybullet.py
2021-08-26 [test:world.py] fixing tests for attach_existing_obj_to_robot
2021-09-09 joint goal fixed
2021-09-10 [plugin_pybullet] removing marker if object attached somewhere
2021-09-10 fixed deepcopy of joint state fuckup
2021-09-13 added prefix to joint and link names
2021-09-13 fixed add urdf
2021-09-13 fixed prismatic mimic joint
2021-09-14 implemented attachment
2021-09-20 plot traj plots env joints
2021-09-21 fixed buggy collision checking with attached objects
2021-09-22 adjusted joint weight, and added robot state publisher. Opening doors will work
2021-10-04 removed memoize from compute chain, because it causes weird bugs
2021-10-04 round to 4 decimal places when printing p_A
2021-10-11 fixed joint goal publisher for python3
2021-10-12 added prints when world is modified
2021-10-18 fixed bug where success was returned when execution got interrupted while the robot is executing the traj
2021-11-03 added cylinder mesh
    [cylinder.obj]
2021-11-11 controlled joints access quick fix
2021-11-22 deleted joint traj splitter and added functionality to send traje behavior
2021-11-23 fixed mimic joints for hsr
2021-12-01 wheel mode
2021-12-02 [god_map] save controlled joints with prefixname obj
2021-12-02 [world] add joints with different prefix to robot
2021-12-02 added cart velocity limit back
2021-12-03 fixed bug in joints, if perdiction horzion is low
2021-12-03 added joint state publisher
2021-12-06 fixed mimic joints
2021-12-08 added parameter to make joint goals hard constraints
2021-12-08 fixed cmake
    [2d_base_bot.urdf]
2021-12-09 giskard will cancel actions servers that take too long to execute
    [2d_base_bot.urdf]
2021-12-10 added hard parameter to joint position range goal
2021-12-14 fixed joint goal publisher and added function to python interface to get controlled joints
2022-02-03 [pr22] updated kitchen test case for pr22
2022-02-08 closed loop control isnt slowed down by sample period anymore
2022-02-24 fixed bug that broke mimic joints, when the kitchen is added
2022-03-24 [tests/donbot] sleeping before sending gripper cmd needed(?) and checking collision of parent links if tip link has none
2022-04-05 fixed bug when attaching objects to kitchen
2022-04-06 fixed attaching to environment
2022-04-06 default robot name is the one from the urdf
2022-04-08 removed urdf object dep from joint limit observer
2022-04-14 reimplemented joints
2022-04-14 [world/plugin] save robot names and some helper funs for detecting groups of links/joints
2022-04-26 localization syncer syncs tf frames now
    [holonomic_base.urdf]
2022-04-27 torso lift joint fails
2022-05-03 removed debug prints
2022-05-04 reduced jerk limits for pr2 odom joints
2022-05-05 [goals] get full link/joint name from link and group name
2022-06-09 dont sync joint state velocity
2022-06-21 [CartesianStraightPos] changed constraint by adding frame
2022-07-21 remove hardcoded map frame
2022-07-25 converting dae to stl before loading
2022-07-27 joint position list now has a unique identifier
2022-08-03 added gripper action server to real tiago
2022-08-04 maybe fixed joint_position_symbols
2022-08-10 better prints when robot is outside of joint limits
2022-08-10 giskard can get out of soft joint limit violations
2022-08-12 stand alone with added urdf environment
2022-08-15 tf syncer only updated frame if it has changed
2022-08-23 fixed bug when removing group that listens to joint states
2022-08-24 added joint list parameter to avoid joint limits goal
2022-08-24 exposed joint_list param of avoid joint limits in python interface
2022-08-25 added option to fix joints for self collision avoidance
2022-08-25 added option to fix joints for self and external collision avoidance and added detector that cancels planning on self collision violation
2022-08-26 out of joint limits exception considers hard limits
2022-08-26 can get into joint limits when outside
2022-08-26 fixed self collision bug with attached objects
2022-08-30 qp solver will print world state if unfeasible
2022-09-07 loop detector tackes velocity limit into account
2022-09-08 fill velocity values for pr2
2022-09-08 exposed limits for omni drive joint
2022-09-12 added script that listens to joy topic and cancels giskard when a button is pressed
2022-09-13 renamed pr2 launch files and implemented tilt from odometry
2022-09-13 omni joint uses roll pitch instead of quaternion
2022-09-13 sync tf frames is more sensitive
2022-09-27 added option to not track position error of base trajectory
2022-10-18 flagged drive joint as controllable in standalone config
2022-10-25 environment urdf are only uploaded once during tests
2022-10-27 fixed bug in mimic joint and in python interface when urdfs are deleted
2022-11-02 joint goals has no dep on pybullet
2022-11-21 refactored casadi wrapper in joints and world
2022-11-21 joint goal works again
2022-11-23 fixed position limits not getting set and wrong velocity limits getting set
2022-11-29 fixed pycharm complaints in joints.py
2022-11-29 fixed pr2 joint goal
2022-11-30 renamed roll pitch yaw in odom joint
2022-12-02 fixed bug that ignored pose when when a urdf is added via ros service
2022-12-02 fixed bug that kept state of urdf objects, even after they got deleted
2022-12-05 implemented debug marker for frames
2022-12-07 fixed bug in translation velocity limit
2022-12-07 fixed bug when joint limits are violated
2022-12-08 caching parent_T_child in joint for speed up
2022-12-12 renamed velocityconstraint to derivativeconstraint
2022-12-21 world raises exception if urdf can not be added
2022-12-21 fixed tracebot mujoco setup
2022-12-22 limited tracy velocity to 0.2
2022-12-28 fixed joint group position controller
2023-01-10 renamed _joints to joint and _links to links
2023-01-10 added option to add drive joint to robot group
2023-01-11 fixed test avoid joint limit tests and wrong params test
2023-01-16 replaced joint file
2023-01-17 fixed tracebot tests
2023-01-18 world keeps track of free variables instead of joints
2023-01-18 fixed omni drive joint
2023-01-18 fixed mimic prismatic joint
2023-01-18 fixed joint goals for mimic prismatic joints
2023-01-19 added tf joints and fixed omni drive with pr2 mujoco sim
2023-01-19 moved logic to update omni drive state from odom sync to joint
2023-01-23 fixed diff drive joint
2023-01-25 fixed bug where mimic joint sometimes had wrong position limits
2023-02-14 added config for iai pr2 and plugin for joint position controllers
2023-02-28 tested velocity robot interface
2023-03-13 added JointGroupPosition controller to control the hsr arm in closed loop mode via interactive markers
    [controller_realtime_test.yaml]
2023-03-13 modified closed-loop control to work with the base of the hsr
    [controller_realtime_test.yaml]
2023-03-14 stop switching to qpoases on git workflows
2023-03-16 using reusable workflow of current branch
2023-03-23 decreased joint convergence threshold and integral constraint weights scale with control horizon
2023-03-23 head joints are not fixed for self collision in hsr anymore
2023-03-23 fixed exception when joint limits are violated
2023-03-27 deleted joint position range goal cause its implementation sucked
2023-03-29 joint goal works again and partly fixed debug pandas
2023-03-30 added filtering of zero weight constraints
2023-03-30 fixed avoid joint limits
2023-03-31 filtering inf entries
2023-03-31 implemented filtering with np bool arrays for expressions
2023-03-31 fixed expression filtering with np bool arrays
2023-03-31 almost got static inf filtering running
2023-04-03 implemented static inf filtering
2023-04-03 inf filtering is faster
2023-04-05 more efficient eq constraint filtering
2023-04-05 filter nAi_Ai with cache
2023-04-05 fixed joint limit violation recovery
2023-04-13 printing qp controller stats
2023-04-14 joint state pretty print is now sorted
2023-04-15 fixed case when there are no neq constraints
2023-04-15 fixed joint violation workaround
2023-04-15 fixed case when there are no position limits and neq constraints
2023-04-18 sync config 2 plugin doesn't wait for joint state anymore
2023-04-18 removed debug expressions in joint goals and fixed bug in qp controller
2023-04-21 fixed tracebot config
2023-04-21 you can overwrite name for odom joints
2023-04-21 resetting default odom joint velocity
2023-04-25 experimental g based on joint limit violation
2023-04-25 fixed are_joint_limits_violated and added tiago test to try to stay out of joint limits
2023-04-25 first try for encoding position limits in velocity limits
2023-04-26 fix for joint position limits, if jerk is not the most limiting factor
2023-04-26 turned off joint limit violation detection in qp controller
2023-04-26 test_attached_get_out_of_collision_and_stay_in_hard_threshold uses a cylinder and reverted loop detector threshold
2023-04-27 diff drive doesn't differentiate between yaw and yaw_vel anymore
2023-04-30 fixed next command filtering
2023-05-02 implemented casadi_wrapper.py.velocity_profile
2023-05-04 first version of velocity_profile
2023-05-04 updated velocity_profile
2023-05-17 resolved name conflict and tracebot setup
2023-05-24 tests for velocity limits
2023-05-25 VelocityLimitUnreachableException is only returned if it's actually not reachable
2023-05-25 pr2 closed loop test doesnt command gripper
2023-05-26 fixed bug where velocity limits of joints that are being mimiced was sometimes wrong
2023-05-31 pr2 head joints are not flagged as fixed for collision avoidance anymore
2023-06-02 pr2 joint goal works again
2023-06-02 fixed collision avoidance with 6dof joint
2023-06-04 added joint goal to pr2 mujoco tests
2023-06-05 move link and joint names in to class attributes in pr2 config
2023-06-23 carry my bullshit stops when laser scan data is too close
2023-06-26 added JointGroupVelController back
2023-06-27 different thresholds for laser and target distance
2023-06-27 added implementation for joint velocity group controller
2023-06-27 resovled set zero velocity conflict
2023-06-28 fixed bug in joint group vel publisher
2023-06-28 inf response filter to update last target pose, if it is too close
2023-06-28 carry my bs starts at current pose
2023-06-28 fixed overwriting of joint limits in config
2023-06-28 new way of laser stop
2023-06-29 cmb: added clear path and fixed laser stop on drive back
2023-06-29 cmb: added prints for drive back and clear path
2023-06-29 cmb: implemented laser avoidance
2023-06-29 cmb: laser avoidance considers both sides
2023-06-29 cmb: laser avoidance with two laser topics
2023-06-30 cmb: added laser_avoidance_sideways_buffer parameter
2023-06-30 cmb: fixed default for laser data
2023-06-30 cmb: laser thresholds are per topic
2023-06-30 laser init can handle even laser ranges
2023-06-30 cmb: implemented laser_avoidance_max_x
2023-06-30 cmb: implemented laser_scan_age_threshold
2023-06-30 cmb: fixed laser avoidance
2023-06-30 cmb can handle no laser data
2023-06-30 cmb: improved laser collision avoidance
2023-07-06 always print time offset
2023-07-06 updating self collision matrix when objects are attached
2023-07-20 load self collision matrix applies updates based on currently controlled joints
2023-07-21 turned fixed joints into a property to make sure it's up to date
2023-07-25 print warning when srdf contains unknown link
2023-07-25 added debug prints to godmap.get_values
2023-07-26 added pr2_test.urdf and uni tests don't call test world anymore
2023-07-27 removed more old files
    [ground_plane.urdf, tiny_ball.urdf]
2023-08-02 added insert cylinder for tracy
2023-08-02 refactored giskard config and pr2 joint goal test works again
2023-08-03 fixed bug where sync tf frames sync the wrong frames
2023-08-09 exposed path tolerance parameter to follow joint traj server
2023-08-10 exposed cylinder height in InsertCylinder
2023-08-18 fixed bug in joint vel publisher
2023-08-24 added tasks and monitors with joint tasks as test
2023-08-25 joint goal for tracebot works again
2023-08-25 insert cylinder works again
2023-08-25 fixed joint position goal for continuous joints
2023-09-12 joint goal works with new interface
2023-09-14 externally linking monitor to goal works with joint goals
2023-09-15 fixed bug that prevented pose update of urdf
2023-09-15 added spoon urdf for test
    [SM_Spoon_1.stl, SM_Spoon_10.stl, SM_Spoon_11.stl, SM_Spoon_12.stl, SM_Spoon_13.stl, SM_Spoon_14.stl, SM_Spoon_15.stl, SM_Spoon_16.stl]
2023-09-15 fixed bug in add urdf
2023-09-29 fixed hsr tests because of urdf changes
2023-10-04 joint goal runs again
2023-10-04 fixed bug in joint goals
2023-10-11 fixed bug where joint symbols where sometimes wrong
2023-10-11 deleted outdated code in joint goals
2023-10-12 planning mode works again for joint traj action server
2023-10-19 follow joint traj interface doesn't require a state topic anymore, but instead a parameter server namespace
2023-10-19 closed loop mode uses sync odometry without lock
2023-10-24 SetExecutionMode prints name of motion type instead of int
2023-10-25 fixed adding of joint state syncer in world updater
2023-11-28 added joint state publisher behaviour and its configuration
2023-11-28 joint state is also published in standalone mode, when giskard is idle and default topic name changed to joint_states
2023-11-28 fixed weight filter for linear weights of qpalm solver
2023-11-29 joint state publisher publishes velocity as well and only consideres revolute and prismatic joints
2023-12-08 optimized qpalm compilation and added non rotational joint check to the goal
2023-12-13 improved check of the kinematic chain in the manipulability goal
2023-12-27 implemented print monitor
2023-12-28 implemented print Print
2023-12-28 implemented sleep monitor and threading for payload monitors
2023-12-29 hsr open fridge test checks if gripper stays at handle
2024-01-02 update parent link payload monitor is threadsafe
2024-01-02 plot gantt chart caches and prints exceptions
2024-01-11 added pr2 test for insert cylinder
2024-01-12 in closed loop mode, if dt is bigger than sample period a warning is printed and dt is capped.
2024-01-16 fixed bug that ignored monitors in conditions with long "and" or "or" chains
2024-01-22 removed useless and confusing print from tests
2024-03-14 experimental velocity controller setup
2024-03-15 trajectory plotter normalizes continuous joints
2024-03-19 increased omni drive base velocities
2024-03-25 client ping runs in thread
2024-04-03 pr2 mujoco launchfile and hack for stop publishing gripper commands
2024-04-03 added velocity parameter to the pouring action goal
2024-04-09 added script to start hand cam servo goal
2024-04-17 added support for multiple quadratic_weigt_gains and scaling betwen arm and base gains in the BaseArmWeightScaling goal
2024-04-17 add to check the state of the gripper
2024-04-19 use joint limit to define minimum door angle
2024-04-19 added reference frame to init of casadi geo types
2024-04-22 added printer class middleware interface
2024-04-24 qp controller doesn't use god_map.sample_period anymore
2024-04-25 - use handle frame to find the intermediate point on the door
2024-04-26 fixed align planes and avoid joint limits
2024-05-03 cmb laser avoidance is implemented as monitor
2024-05-15 add test for simple pouring and velocity limits
2024-05-31 giskard will now print a warning only if the final motion goal has no end or cancel monitor
2024-06-06 joint goal reached works again
2024-06-07 add urdf catches all exceptions during parsing
2024-06-20 fixed insert cylinder goal
2024-06-24 fixed bug where open goal couldn't be used twice for the same joint
2024-06-24 added exceptions for force torque error codes
2024-06-25 fixed bug where add_urdf ignores collision of urdf root link
2024-06-25 refactored world tests and moved world and collision config to giskardpy
    [simple_two_arm_robot.urdf]
2024-07-12 can send joint goal
2024-07-15 use print to show found solver
2024-08-07 fixed bug where fixed joints would use numpy arrays
2024-08-12 fixed drive joint
2024-08-14 get_drive_joint checks type of provided joint name
2024-08-14 world with omni drive takes urdf as init param instead of setup
2024-08-15 pr2 notebook to 10hz
2024-08-16 switch pr2 vrb to 20hz
2024-08-19 visualization markers are cleared when world has changed in framelocked mode
2024-08-19 added default threshold for joint goal reached
2024-08-31 fixed debug traj marker for frames
2024-09-19 group_name in add robot urdf is optional
2024-09-20 joint task worked
2024-09-20 joint goal checks when it's done
2024-10-28 don't use cas.ifinf for finite filter
2024-10-28 fixed implicit qp controller if multiple joints
2024-10-29 number of ineq constraints was too low in stats print
2024-10-31 implemented proxsuite
    [pr2.urdf]
2024-11-21 fixed edge case in position limits
2024-11-26 debug expressins for joint goals
2024-11-26 infeasibility fail safe added for joints without position limits
2024-12-05 fixed bug in joint task debug code
2025-01-15 fix pr2 joint tests
2025-01-20 first joint test with new lib interface works
2025-01-21 added cart and joint goal to userinterface
2025-01-30 added library usage example
    [simple_7_dof_arm.urdf]
2025-03-13 fixed bug where substitute lost reference frames and gave cart pose straight obs state
2025-03-20 added case for Download_URL for pr-request
2025-04-04 added pr2.urdf creation to Dockerfile
2025-04-08 fixed joint goals for mimic joints
2025-04-08 moving pr2.urdf from root to test/urdfs in workflow
2025-04-14 added caching for joint transformations
2025-05-16 implemented JointPositionAbove
2025-05-26 created WiggleInsert-Task with random-sample or random_walk added float_to_symbol to get_expr
2025-06-03 added hole point to visualization and removed dt parameter from wiggle insert
2025-06-06 fixed bug where wiggle goal expected hole_point to be a pose
2026-06-29 Update README to reflect library relocation
    Added a note indicating the library has moved and provided a link to the current version.
